flkochu/Arca9/datos/2026-11-09_flexion_fl/resumen.md

# Prueba 08 · Flexión y extensión — 20261109_182700

Rodilla FL (canal 2), de 5.0° a 125.8° de flexión (121°), cadera a +0°. 2 vueltas por velocidad. Fuente: 6.0 V.

| Velocidad pedida | Movimiento | Latencia (ms) | Atraso en la rampa (ms) | Vel. real (°/s) | Vel. pico (°/s) | Sobrepaso (°) | Asentamiento (ms) | Tiempo total (ms) | Error final (°) |
|---|---|---|---|---|---|---|---|---|---|
| 60 °/s | flexión | 76 | 105 | 61 | 94 | 0.2 | 117 | 2113 | 0.7 |
| 60 °/s | extensión | 84 | 86 | 60 | 118 | 0.3 | 91 | 2101 | 0.9 |
| 120 °/s | flexión | 67 | 101 | 120 | 176 | 0.2 | 146 | 1149 | 0.5 |
| 120 °/s | extensión | 76 | 97 | 120 | 212 | 0.3 | 165 | 1166 | 1.1 |
| 180 °/s | flexión | 53 | 102 | 180 | 229 | 0.2 | 177 | 840 | 0.6 |
| 180 °/s | extensión | 78 | 101 | 179 | 260 | 0.2 | 176 | 841 | 1.1 |
| 240 °/s | flexión | 54 | 104 | 237 | 273 | 0.2 | 184 | 682 | 0.8 |
| 240 °/s | extensión | 89 | 105 | 242 | 315 | 0.2 | 194 | 685 | 1.1 |
| máx. 376 °/s | flexión | 55 | 135 | 265 | 287 | 0.2 | 290 | 605 | 0.9 |
| máx. 376 °/s | extensión | 96 | 125 | 277 | 316 | 0.2 | 283 | 589 | 1.0 |

- **Latencia:** desde que el pedido se movió 2° hasta que el cable verde se movió 2°.
- **Tiempo total:** desde el primer pulso nuevo hasta que la rodilla quedó a ±1° de donde se quedó.
- **Atraso en la rampa:** en la segunda mitad de la rampa (como la prueba 04); a la velocidad máxima la rampa dura muy poco (0.3 s) y es menos confiable.
