flkochu/Arca9/datos/2026-11-03_marcha/resumen.md

# 05 · Marcha en el aire — resumen

| | |
|---|---|
| Fecha | 20261103_194555 |
| Pata | FL (canales [0, 1, 2]) |
| Paso | 6 cm de largo, 3 cm de alto, centro en x = 2 cm, z = 18.5 cm; 60 % de apoyo; 4 pasos por corrida |
| Adelanto | 100 ms |
| Fuente | 5.99 V |
| Simulado | no |

| Periodo (s) | Modo | Pie RMS (cm) | Pie máx (cm) | Largo hecho (cm) | Alto hecho (cm) | Cadera RMS (°) | Rodilla RMS (°) | Abducción RMS (°) | Atraso cadera (ms) | Atraso rodilla (ms) |
|---|---|---|---|---|---|---|---|---|---|---|
| 2 | sin compensar | 0.99 | 2.34 | 6.3 | 3.0 | 3.4 | 4.1 | 1.5 | 100 | 106 |
| 2 | con adelanto | 0.51 | 0.83 | 6.3 | 3.0 | 1.1 | 1.0 | 1.5 | 0 | 8 |
| 1.2 | sin compensar | 1.46 | 3.21 | 6.1 | 2.7 | 5.2 | 6.1 | 1.5 | 100 | 106 |
| 1.2 | con adelanto | 0.50 | 0.98 | 6.2 | 2.7 | 1.2 | 1.2 | 1.5 | 0 | 6 |
| 0.8 | sin compensar | 1.95 | 3.96 | 6.0 | 2.7 | 7.1 | 7.9 | 1.5 | 98 | 102 |
| 0.8 | con adelanto | 0.49 | 0.89 | 6.0 | 2.7 | 1.4 | 1.5 | 1.5 | 2 | 6 |

Lo pedido: 6 cm de largo y 3 cm de alto. El alto hecho incluye la diferencia de altura entre el apoyo y el punto más alto del vuelo.
