flkochu/Arca9/datos/2026-11-02_rampas/resumen.md

# 04 · Rampas — resumen

| | |
|---|---|
| Fecha | 20261102_212328 |
| Recorrido | 30° → 150° reales (819 → 2097 µs) |
| Vueltas | 3 idas y vueltas por servo y velocidad, 500 ms quieto en cada extremo |
| Fuente | 5.99 V |
| Simulado | no |
| Completa | sí |

## Promedio de los servos, por velocidad

Entre paréntesis, el servo con el valor más bajo y el más alto.

| Pedida (°/s) | Velocidad real (°/s) | Error en la rampa (°) | Atraso (ms) | Error máx (°) | Sobrepaso (°) | Asentamiento (ms) | Error final (°) |
|---|---|---|---|---|---|---|---|
| 60 | 60 (59–60) | 6.0 (5.8–6.2) | 100 (96–103) | 7.7 (7.1–8.4) | 0.76 (0.28–1.68) | 222 (91–464) | -0.83 (-1.36–-0.39) |
| 100 | 99 (99–100) | 10.2 (9.7–10.5) | 102 (97–105) | 12.3 (11.6–12.8) | 0.73 (0.22–1.33) | 234 (128–426) | -0.51 (-0.63–-0.26) |
| 120 | 119 (118–120) | 12.3 (11.8–12.7) | 103 (98–106) | 14.6 (13.8–14.9) | 0.49 (0.20–1.00) | 168 (132–253) | -0.35 (-0.62–-0.19) |
| 160 | 158 (156–160) | 16.4 (15.8–16.9) | 103 (99–106) | 19.2 (18.4–19.9) | 0.52 (0.19–1.03) | 191 (155–310) | -0.35 (-0.60–-0.17) |
| 180 | 179 (173–185) | 18.7 (17.8–19.3) | 104 (99–107) | 21.7 (20.9–22.3) | 0.73 (0.37–1.09) | 247 (170–358) | -0.24 (-0.49–0.01) |
| 200 | 199 (196–202) | 20.9 (20.1–21.7) | 104 (100–108) | 24.3 (23.3–24.9) | 0.83 (0.28–1.26) | 306 (173–450) | -0.21 (-0.37–0.15) |
| 220 | 219 (217–221) | 23.2 (22.4–23.9) | 105 (102–109) | 26.9 (25.7–27.5) | 1.11 (0.31–2.50) | 345 (166–485) | -0.27 (-0.50–-0.03) |
| 240 | 238 (236–241) | 25.6 (24.7–26.3) | 107 (103–110) | 29.7 (28.4–30.6) | 1.51 (0.44–2.86) | 378 (197–488) | -0.26 (-0.56–0.02) |

## Error en la rampa por servo (°)

| Servo | 60 °/s | 100 °/s | 120 °/s | 160 °/s | 180 °/s | 200 °/s | 220 °/s | 240 °/s |
|---|---|---|---|---|---|---|---|---|
| 0 · FL abducción | 5.8 | 9.7 | 11.8 | 15.9 | 18.1 | 20.3 | 22.4 | 24.8 |
| 1 · FL cadera | 5.8 | 9.7 | 11.9 | 15.8 | 17.8 | 20.1 | 22.5 | 24.7 |
| 2 · FL rodilla | 5.9 | 9.9 | 12.0 | 16.1 | 18.4 | 20.7 | 22.9 | 25.2 |
| 3 · FR abducción | 6.2 | 10.3 | 12.5 | 16.8 | 18.8 | 21.1 | 23.4 | 26.0 |
| 4 · FR cadera | 6.1 | 10.4 | 12.4 | 16.7 | 19.1 | 21.2 | 23.5 | 25.9 |
| 5 · FR rodilla | 6.2 | 10.5 | 12.6 | 16.9 | 19.3 | 21.7 | 23.9 | 26.3 |
| 6 · RL abducción | 5.9 | 10.1 | 12.1 | 16.2 | 18.5 | 20.5 | 22.8 | 25.2 |
| 7 · RL cadera | 6.0 | 10.3 | 12.6 | 16.6 | 19.0 | 21.1 | 23.3 | 25.9 |
| 8 · RL rodilla | 6.1 | 10.2 | 12.4 | 16.5 | 18.6 | 20.8 | 22.9 | 25.7 |
| 9 · RR abducción | 6.1 | 10.4 | 12.5 | 16.6 | 18.6 | 20.9 | 23.4 | 26.0 |
| 10 · RR cadera | 6.0 | 10.3 | 12.3 | 16.4 | 18.7 | 21.0 | 23.1 | 25.5 |
| 11 · RR rodilla | 6.2 | 10.5 | 12.7 | 16.8 | 18.9 | 21.1 | 23.6 | 26.0 |

## Atraso por servo (ms)

| Servo | 60 °/s | 100 °/s | 120 °/s | 160 °/s | 180 °/s | 200 °/s | 220 °/s | 240 °/s |
|---|---|---|---|---|---|---|---|---|
| 0 · FL abducción | 97 | 97 | 98 | 99 | 100 | 101 | 102 | 104 |
| 1 · FL cadera | 96 | 97 | 99 | 99 | 99 | 100 | 102 | 103 |
| 2 · FL rodilla | 98 | 99 | 100 | 100 | 102 | 104 | 104 | 105 |
| 3 · FR abducción | 103 | 103 | 104 | 105 | 104 | 105 | 106 | 108 |
| 4 · FR cadera | 102 | 104 | 104 | 104 | 106 | 106 | 107 | 108 |
| 5 · FR rodilla | 103 | 105 | 105 | 106 | 107 | 108 | 109 | 110 |
| 6 · RL abducción | 98 | 101 | 101 | 101 | 103 | 102 | 104 | 105 |
| 7 · RL cadera | 100 | 103 | 105 | 104 | 106 | 106 | 106 | 108 |
| 8 · RL rodilla | 101 | 102 | 103 | 103 | 103 | 104 | 104 | 107 |
| 9 · RR abducción | 101 | 104 | 104 | 104 | 104 | 104 | 106 | 108 |
| 10 · RR cadera | 99 | 103 | 103 | 102 | 104 | 105 | 105 | 106 |
| 11 · RR rodilla | 103 | 105 | 106 | 105 | 105 | 106 | 107 | 108 |
