flkochu/Arca9/datos/README.md

# Datos

Una carpeta por corrida real, con el nombre `AAAA-MM-DD_prueba`. Se copian tal como las deja el
script, sin editarlas. La nota de cada una está en `docs/bitacora/`.

| Carpeta | Prueba |
|---|---|
| `2026-10-29_eficiencia_12_servos/` | [01 · Eficiencia de los 12 servos](../docs/bitacora/01_eficiencia_servos.md) |
| `2026-11-03_marcha/` | [05 · Marcha en el aire con la pata FL](../docs/bitacora/05_marcha_aire.md) |
| `2026-11-03_pata_fl/` | Medidas de la pata FL armada: largos, límites, poses y sentidos (`pata_fl.json`, lo lee `pc/pata.py`) |
| `2026-11-02_rampas/` | [04 · Rampas: velocidad contra error](../docs/bitacora/04_rampas.md). Analizada con la versión corregida de `rampas.py` (segunda mitad de cada rampa) |
| `2026-11-02_angulo_real/` | [02 · Ángulo real, con transportador](../docs/bitacora/02_angulo_real.md). Medida a mano; `escala.json` lo lee `pc/escala.py` |
