flkochu/Arca9/datos/2026-10-29_eficiencia_12_servos/canal0/tabla.md

# Canal 0 · FL abducción

- Rango útil: 0° a 168° (500–2367 µs), 191–1867 mV en el pin
- Recta: ángulo = -0.10018·mV +186.87  (9.98 mV por grado), R² = 0.99996
- Error con la recta: RMS 0.32°, máx 0.94°, 100 % de los puntos dentro de ±1°
- Error con la tabla (de 2 en 2°, probada con otras pasadas): RMS 0.22°, máx 0.61°, 100 % dentro de ±1°
- Histéresis: máx 0.87°, media 0.24°
- Ruido con el servo quieto: σ 2.98 mV = 0.299°
- Por pasada (recta de cada una contra la de todos los datos):
  - de 30 en 30°: 12 puntos, R² 0.99997, se separa hasta 0.06°, error RMS 0.27°
  - de 20 en 20°: 18 puntos, R² 0.99997, se separa hasta 0.07°, error RMS 0.28°
  - de 10 en 10°: 34 puntos, R² 0.99997, se separa hasta 0.03°, error RMS 0.27°
  - de 5 en 5°: 68 puntos, R² 0.99996, se separa hasta 0.03°, error RMS 0.31°
  - de 2 en 2°: 170 puntos, R² 0.99995, se separa hasta 0.02°, error RMS 0.34°

## Pasada 1: de 30 en 30°

| Ángulo (°) | Pulso (µs) | mV ↑ | mV ↓ | Medido (°) | Error (°) | Histéresis (°) | |
|---|---|---|---|---|---|---|---|
| 0 | 500 | 1864.2 | 1867.1 | -0.03 | -0.03 | 0.29 |  |
| 30 | 833 | 1569.9 | 1568.0 | 29.70 | -0.30 | 0.19 |  |
| 60 | 1167 | 1267.8 | 1261.7 | 60.17 | +0.17 | 0.61 |  |
| 90 | 1500 | 965.2 | 964.8 | 90.20 | +0.20 | 0.04 |  |
| 120 | 1833 | 671.7 | 670.4 | 119.64 | -0.36 | 0.13 |  |
| 150 | 2167 | 368.4 | 367.0 | 150.03 | +0.03 | 0.14 |  |
| 175 | 2444 | 193.2 | 193.0 | 167.52 | -7.48 | 0.02 | fuera |

## Pasada 2: de 20 en 20°

| Ángulo (°) | Pulso (µs) | mV ↑ | mV ↓ | Medido (°) | Error (°) | Histéresis (°) | |
|---|---|---|---|---|---|---|---|
| 0 | 500 | 1867.0 | 1865.4 | -0.08 | -0.08 | 0.16 |  |
| 20 | 722 | 1668.3 | 1666.7 | 19.82 | -0.18 | 0.16 |  |
| 40 | 944 | 1468.1 | 1466.1 | 39.90 | -0.10 | 0.20 |  |
| 60 | 1167 | 1268.4 | 1266.6 | 59.89 | -0.11 | 0.18 |  |
| 80 | 1389 | 1066.0 | 1066.0 | 80.08 | +0.08 | 0.00 |  |
| 100 | 1611 | 862.2 | 862.5 | 100.48 | +0.48 | 0.03 |  |
| 120 | 1833 | 667.7 | 669.9 | 119.87 | -0.13 | 0.22 |  |
| 140 | 2056 | 467.4 | 465.1 | 140.16 | +0.16 | 0.23 |  |
| 160 | 2278 | 274.2 | 273.1 | 159.45 | -0.55 | 0.11 |  |
| 175 | 2444 | 190.8 | 191.0 | 167.74 | -7.26 | 0.02 | fuera |

## Pasada 3: de 10 en 10°

| Ángulo (°) | Pulso (µs) | mV ↑ | mV ↓ | Medido (°) | Error (°) | Histéresis (°) | |
|---|---|---|---|---|---|---|---|
| 0 | 500 | 1864.9 | 1863.6 | 0.11 | +0.11 | 0.13 |  |
| 10 | 611 | 1765.5 | 1767.8 | 9.89 | -0.11 | 0.23 |  |
| 20 | 722 | 1666.6 | 1666.5 | 19.92 | -0.08 | 0.01 |  |
| 30 | 833 | 1571.5 | 1567.5 | 29.64 | -0.36 | 0.40 |  |
| 40 | 944 | 1468.2 | 1467.3 | 39.83 | -0.17 | 0.09 |  |
| 50 | 1056 | 1367.0 | 1366.4 | 49.96 | -0.04 | 0.06 |  |
| 60 | 1167 | 1267.5 | 1264.6 | 60.04 | +0.04 | 0.29 |  |
| 70 | 1278 | 1167.0 | 1161.6 | 70.23 | +0.23 | 0.54 |  |
| 80 | 1389 | 1064.4 | 1065.5 | 80.18 | +0.18 | 0.11 |  |
| 90 | 1500 | 966.9 | 965.3 | 90.09 | +0.09 | 0.16 |  |
| 100 | 1611 | 864.9 | 861.2 | 100.41 | +0.41 | 0.37 |  |
| 110 | 1722 | 762.8 | 764.4 | 110.37 | +0.37 | 0.16 |  |
| 120 | 1833 | 670.2 | 670.2 | 119.73 | -0.27 | 0.00 |  |
| 130 | 1944 | 569.3 | 568.7 | 129.87 | -0.13 | 0.06 |  |
| 140 | 2056 | 468.9 | 466.9 | 140.00 | -0.00 | 0.20 |  |
| 150 | 2167 | 370.1 | 365.2 | 150.04 | +0.04 | 0.49 |  |
| 160 | 2278 | 273.3 | 273.3 | 159.49 | -0.51 | 0.00 |  |
| 170 | 2389 | 189.3 | 189.4 | 167.90 | -2.10 | 0.01 | fuera |
| 175 | 2444 | 189.6 | 189.6 | 167.87 | -7.13 | 0.00 | fuera |

## Pasada 4: de 5 en 5°

| Ángulo (°) | Pulso (µs) | mV ↑ | mV ↓ | Medido (°) | Error (°) | Histéresis (°) | |
|---|---|---|---|---|---|---|---|
| 0 | 500 | 1864.2 | 1864.2 | 0.12 | +0.12 | 0.00 |  |
| 5 | 556 | 1819.9 | 1816.4 | 4.73 | -0.27 | 0.35 |  |
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
| 72 | 1300 | 1148.9 | 1147.0 | 71.87 | -0.13 | 0.19 |  |
| 74 | 1322 | 1127.4 | 1126.8 | 73.96 | -0.04 | 0.06 |  |
| 76 | 1344 | 1108.7 | 1106.4 | 75.92 | -0.08 | 0.23 |  |
| 78 | 1367 | 1085.5 | 1083.6 | 78.22 | +0.22 | 0.19 |  |
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
| 170 | 2389 | 190.9 | 191.3 | 167.72 | -2.28 | 0.04 | fuera |
| 172 | 2411 | 192.0 | 191.1 | 167.68 | -4.32 | 0.09 | fuera |
| 174 | 2433 | 190.9 | 190.8 | 167.75 | -6.25 | 0.01 | fuera |
| 175 | 2444 | 191.1 | 191.2 | 167.72 | -7.28 | 0.01 | fuera |

## Avisos

- Fuera del rango útil (llegó a su tope o no siguió el comando): 170, 172, 174, 175°.
