flkochu/Arca9/datos/2026-10-29_eficiencia_12_servos/canal1/tabla.md

# Canal 1 · FL cadera

- Rango útil: 0° a 168° (500–2367 µs), 192–1858 mV en el pin
- Recta: ángulo = -0.10071·mV +186.94  (9.93 mV por grado), R² = 0.99996
- Error con la recta: RMS 0.32°, máx 0.98°, 100 % de los puntos dentro de ±1°
- Error con la tabla (de 2 en 2°, probada con otras pasadas): RMS 0.25°, máx 0.87°, 100 % dentro de ±1°
- Histéresis: máx 1.01°, media 0.20°
- Ruido con el servo quieto: σ 3.28 mV = 0.330°
- Por pasada (recta de cada una contra la de todos los datos):
  - de 30 en 30°: 12 puntos, R² 0.99998, se separa hasta 0.13°, error RMS 0.22°
  - de 20 en 20°: 18 puntos, R² 0.99998, se separa hasta 0.09°, error RMS 0.27°
  - de 10 en 10°: 34 puntos, R² 0.99997, se separa hasta 0.11°, error RMS 0.29°
  - de 5 en 5°: 68 puntos, R² 0.99995, se separa hasta 0.01°, error RMS 0.33°
  - de 2 en 2°: 170 puntos, R² 0.99995, se separa hasta 0.04°, error RMS 0.34°

## Pasada 1: de 30 en 30°

| Ángulo (°) | Pulso (µs) | mV ↑ | mV ↓ | Medido (°) | Error (°) | Histéresis (°) | |
|---|---|---|---|---|---|---|---|
| 0 | 500 | 1857.5 | 1857.0 | -0.11 | -0.11 | 0.05 |  |
| 30 | 833 | 1558.3 | 1557.6 | 30.04 | +0.04 | 0.07 |  |
| 60 | 1167 | 1259.6 | 1262.1 | 59.96 | -0.04 | 0.25 |  |
| 90 | 1500 | 959.7 | 958.1 | 90.37 | +0.37 | 0.16 |  |
| 120 | 1833 | 665.8 | 666.4 | 119.86 | -0.14 | 0.06 |  |
| 150 | 2167 | 368.5 | 371.0 | 149.70 | -0.30 | 0.25 |  |
| 175 | 2444 | 190.7 | 191.5 | 167.69 | -7.31 | 0.08 | fuera |

## Pasada 2: de 20 en 20°

| Ángulo (°) | Pulso (µs) | mV ↑ | mV ↓ | Medido (°) | Error (°) | Histéresis (°) | |
|---|---|---|---|---|---|---|---|
| 0 | 500 | 1857.9 | 1856.0 | -0.08 | -0.08 | 0.19 |  |
| 20 | 722 | 1661.7 | 1661.4 | 19.60 | -0.40 | 0.03 |  |
| 40 | 944 | 1460.5 | 1458.8 | 39.94 | -0.06 | 0.17 |  |
| 60 | 1167 | 1260.8 | 1259.9 | 60.01 | +0.01 | 0.09 |  |
| 80 | 1389 | 1059.8 | 1061.3 | 80.13 | +0.13 | 0.15 |  |
| 100 | 1611 | 862.6 | 858.9 | 100.25 | +0.25 | 0.37 |  |
| 120 | 1833 | 668.0 | 664.0 | 119.87 | -0.13 | 0.40 |  |
| 140 | 2056 | 465.0 | 465.3 | 140.09 | +0.09 | 0.03 |  |
| 160 | 2278 | 271.7 | 273.6 | 159.48 | -0.52 | 0.19 |  |
| 175 | 2444 | 191.5 | 191.7 | 167.64 | -7.36 | 0.02 | fuera |

## Pasada 3: de 10 en 10°

| Ángulo (°) | Pulso (µs) | mV ↑ | mV ↓ | Medido (°) | Error (°) | Histéresis (°) | |
|---|---|---|---|---|---|---|---|
| 0 | 500 | 1856.2 | 1856.6 | -0.02 | -0.02 | 0.04 |  |
| 10 | 611 | 1757.7 | 1756.1 | 10.00 | -0.00 | 0.16 |  |
| 20 | 722 | 1659.6 | 1661.5 | 19.70 | -0.30 | 0.19 |  |
| 30 | 833 | 1557.5 | 1558.4 | 30.04 | +0.04 | 0.09 |  |
| 40 | 944 | 1461.5 | 1460.3 | 39.81 | -0.19 | 0.12 |  |
| 50 | 1056 | 1364.6 | 1361.4 | 49.67 | -0.33 | 0.32 |  |
| 60 | 1167 | 1261.2 | 1262.1 | 59.88 | -0.12 | 0.09 |  |
| 70 | 1278 | 1160.0 | 1159.9 | 70.12 | +0.12 | 0.01 |  |
| 80 | 1389 | 1060.2 | 1058.8 | 80.24 | +0.24 | 0.14 |  |
| 90 | 1500 | 959.3 | 961.3 | 90.23 | +0.23 | 0.20 |  |
| 100 | 1611 | 859.3 | 858.1 | 100.46 | +0.46 | 0.12 |  |
| 110 | 1722 | 760.3 | 759.4 | 110.41 | +0.41 | 0.09 |  |
| 120 | 1833 | 666.1 | 666.5 | 119.84 | -0.16 | 0.04 |  |
| 130 | 1944 | 567.3 | 566.4 | 129.85 | -0.15 | 0.09 |  |
| 140 | 2056 | 467.3 | 466.0 | 139.94 | -0.06 | 0.13 |  |
| 150 | 2167 | 370.8 | 368.8 | 149.70 | -0.30 | 0.20 |  |
| 160 | 2278 | 274.1 | 273.6 | 159.36 | -0.64 | 0.05 |  |
| 170 | 2389 | 190.4 | 190.7 | 167.75 | -2.25 | 0.03 | fuera |
| 175 | 2444 | 190.8 | 190.7 | 167.73 | -7.27 | 0.01 | fuera |

## Pasada 4: de 5 en 5°

| Ángulo (°) | Pulso (µs) | mV ↑ | mV ↓ | Medido (°) | Error (°) | Histéresis (°) | |
|---|---|---|---|---|---|---|---|
| 0 | 500 | 1857.5 | 1855.6 | -0.04 | -0.04 | 0.19 |  |
| 5 | 556 | 1810.6 | 1810.4 | 4.60 | -0.40 | 0.02 |  |
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
| 72 | 1300 | 1141.5 | 1140.3 | 72.04 | +0.04 | 0.12 |  |
| 74 | 1322 | 1118.0 | 1118.6 | 74.31 | +0.31 | 0.06 |  |
| 76 | 1344 | 1106.3 | 1099.7 | 75.85 | -0.15 | 0.66 |  |
| 78 | 1367 | 1083.2 | 1080.6 | 77.98 | -0.02 | 0.26 |  |
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
| 170 | 2389 | 192.8 | 192.8 | 167.52 | -2.48 | 0.00 | fuera |
| 172 | 2411 | 192.6 | 192.7 | 167.54 | -4.46 | 0.01 | fuera |
| 174 | 2433 | 192.9 | 192.7 | 167.52 | -6.48 | 0.02 | fuera |
| 175 | 2444 | 192.6 | 192.2 | 167.56 | -7.44 | 0.04 | fuera |

## Avisos

- Fuera del rango útil (llegó a su tope o no siguió el comando): 170, 172, 174, 175°.
