flkochu/Arca9/datos/2026-10-29_eficiencia_12_servos/canal10/tabla.md

# Canal 10 · RR cadera

- Rango útil: 0° a 170° (500–2389 µs), 180–1858 mV en el pin
- Recta: ángulo = -0.10051·mV +186.66  (9.95 mV por grado), R² = 0.99994
- Error con la recta: RMS 0.40°, máx 1.83°, 98 % de los puntos dentro de ±1°
- Error con la tabla (de 2 en 2°, probada con otras pasadas): RMS 0.24°, máx 1.02°, 99 % dentro de ±1°
- Histéresis: máx 0.80°, media 0.22°
- Ruido con el servo quieto: σ 5.53 mV = 0.555°
- Por pasada (recta de cada una contra la de todos los datos):
  - de 30 en 30°: 12 puntos, R² 0.99999, se separa hasta 0.16°, error RMS 0.16°
  - de 20 en 20°: 18 puntos, R² 0.99997, se separa hasta 0.19°, error RMS 0.31°
  - de 10 en 10°: 36 puntos, R² 0.99992, se separa hasta 0.23°, error RMS 0.49°
  - de 5 en 5°: 70 puntos, R² 0.99992, se separa hasta 0.06°, error RMS 0.44°
  - de 2 en 2°: 172 puntos, R² 0.99994, se separa hasta 0.10°, error RMS 0.39°

## Pasada 1: de 30 en 30°

| Ángulo (°) | Pulso (µs) | mV ↑ | mV ↓ | Medido (°) | Error (°) | Histéresis (°) | |
|---|---|---|---|---|---|---|---|
| 0 | 500 | 1856.5 | 1858.1 | -0.02 | -0.02 | 0.16 |  |
| 30 | 833 | 1558.4 | 1559.2 | 29.98 | -0.02 | 0.08 |  |
| 60 | 1167 | 1262.7 | 1258.3 | 59.97 | -0.03 | 0.44 |  |
| 90 | 1500 | 963.8 | 964.6 | 89.75 | -0.25 | 0.08 |  |
| 120 | 1833 | 664.0 | 665.4 | 119.85 | -0.15 | 0.14 |  |
| 150 | 2167 | 366.1 | 364.4 | 149.95 | -0.05 | 0.17 |  |
| 175 | 2444 | 183.8 | 182.9 | 168.23 | -6.77 | 0.09 | fuera |

## Pasada 2: de 20 en 20°

| Ángulo (°) | Pulso (µs) | mV ↑ | mV ↓ | Medido (°) | Error (°) | Histéresis (°) | |
|---|---|---|---|---|---|---|---|
| 0 | 500 | 1857.5 | 1857.5 | -0.04 | -0.04 | 0.00 |  |
| 20 | 722 | 1659.9 | 1658.5 | 19.89 | -0.11 | 0.14 |  |
| 40 | 944 | 1459.7 | 1460.0 | 39.93 | -0.07 | 0.03 |  |
| 60 | 1167 | 1263.7 | 1261.9 | 59.74 | -0.26 | 0.18 |  |
| 80 | 1389 | 1058.0 | 1057.8 | 80.33 | +0.33 | 0.02 |  |
| 100 | 1611 | 861.2 | 858.7 | 100.23 | +0.23 | 0.25 |  |
| 120 | 1833 | 663.6 | 666.0 | 119.84 | -0.16 | 0.24 |  |
| 140 | 2056 | 463.4 | 462.1 | 140.15 | +0.15 | 0.13 |  |
| 160 | 2278 | 273.1 | 271.7 | 159.28 | -0.72 | 0.14 |  |
| 175 | 2444 | 185.7 | 186.2 | 167.97 | -7.03 | 0.05 | fuera |

## Pasada 3: de 10 en 10°

| Ángulo (°) | Pulso (µs) | mV ↑ | mV ↓ | Medido (°) | Error (°) | Histéresis (°) | |
|---|---|---|---|---|---|---|---|
| 0 | 500 | 1857.8 | 1858.2 | -0.09 | -0.09 | 0.04 |  |
| 10 | 611 | 1761.8 | 1758.0 | 9.77 | -0.23 | 0.38 |  |
| 20 | 722 | 1661.7 | 1659.7 | 19.74 | -0.26 | 0.20 |  |
| 30 | 833 | 1560.0 | 1559.6 | 29.88 | -0.12 | 0.04 |  |
| 40 | 944 | 1458.7 | 1460.2 | 39.97 | -0.03 | 0.15 |  |
| 50 | 1056 | 1358.5 | 1358.9 | 50.10 | +0.10 | 0.04 |  |
| 60 | 1167 | 1262.2 | 1259.0 | 59.96 | -0.04 | 0.32 |  |
| 70 | 1278 | 1161.0 | 1161.2 | 69.96 | -0.04 | 0.02 |  |
| 80 | 1389 | 1059.9 | 1058.1 | 80.22 | +0.22 | 0.18 |  |
| 90 | 1500 | 956.9 | 959.8 | 90.34 | +0.34 | 0.29 |  |
| 100 | 1611 | 859.6 | 858.9 | 100.30 | +0.30 | 0.07 |  |
| 110 | 1722 | 758.7 | 758.1 | 110.43 | +0.43 | 0.06 |  |
| 120 | 1833 | 662.8 | 661.7 | 120.10 | +0.10 | 0.11 |  |
| 130 | 1944 | 564.9 | 562.4 | 130.01 | +0.01 | 0.25 |  |
| 140 | 2056 | 463.4 | 459.8 | 140.26 | +0.26 | 0.36 |  |
| 150 | 2167 | 364.7 | 365.4 | 149.97 | -0.03 | 0.07 |  |
| 160 | 2278 | 271.4 | 265.4 | 159.68 | -0.32 | 0.60 |  |
| 170 | 2389 | 183.5 | 184.0 | 168.19 | -1.81 | 0.05 |  |
| 175 | 2444 | 184.3 | 183.9 | 168.16 | -6.84 | 0.04 | fuera |

## Pasada 4: de 5 en 5°

| Ángulo (°) | Pulso (µs) | mV ↑ | mV ↓ | Medido (°) | Error (°) | Histéresis (°) | |
|---|---|---|---|---|---|---|---|
| 0 | 500 | 1857.5 | 1855.9 | 0.04 | +0.04 | 0.16 |  |
| 5 | 556 | 1810.8 | 1809.7 | 4.71 | -0.29 | 0.11 |  |
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
| 72 | 1300 | 1141.9 | 1142.4 | 71.86 | -0.14 | 0.05 |  |
| 74 | 1322 | 1121.5 | 1117.8 | 74.12 | +0.12 | 0.37 |  |
| 76 | 1344 | 1103.7 | 1098.8 | 75.97 | -0.03 | 0.49 |  |
| 78 | 1367 | 1080.0 | 1078.3 | 78.19 | +0.19 | 0.17 |  |
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
| 172 | 2411 | 181.2 | 181.0 | 168.46 | -3.54 | 0.02 | fuera |
| 174 | 2433 | 181.1 | 180.9 | 168.47 | -5.53 | 0.02 | fuera |
| 175 | 2444 | 181.1 | 180.4 | 168.49 | -6.51 | 0.07 | fuera |

## Avisos

- Fuera del rango útil (llegó a su tope o no siguió el comando): 172, 174, 175°.
