flkochu/Arca9/datos/2026-10-29_eficiencia_12_servos/canal11/tabla.md

# Canal 11 · RR rodilla

- Rango útil: 0° a 168° (500–2367 µs), 185–1878 mV en el pin
- Recta: ángulo = -0.09912·mV +186.08  (10.09 mV por grado), R² = 0.99996
- Error con la recta: RMS 0.32°, máx 0.89°, 100 % de los puntos dentro de ±1°
- Error con la tabla (de 2 en 2°, probada con otras pasadas): RMS 0.22°, máx 0.56°, 100 % dentro de ±1°
- Histéresis: máx 0.73°, media 0.22°
- Ruido con el servo quieto: σ 4.23 mV = 0.419°
- Por pasada (recta de cada una contra la de todos los datos):
  - de 30 en 30°: 12 puntos, R² 0.99999, se separa hasta 0.15°, error RMS 0.20°
  - de 20 en 20°: 18 puntos, R² 0.99997, se separa hasta 0.18°, error RMS 0.29°
  - de 10 en 10°: 34 puntos, R² 0.99996, se separa hasta 0.10°, error RMS 0.33°
  - de 5 en 5°: 68 puntos, R² 0.99995, se separa hasta 0.04°, error RMS 0.33°
  - de 2 en 2°: 170 puntos, R² 0.99996, se separa hasta 0.06°, error RMS 0.32°

## Pasada 1: de 30 en 30°

| Ángulo (°) | Pulso (µs) | mV ↑ | mV ↓ | Medido (°) | Error (°) | Histéresis (°) | |
|---|---|---|---|---|---|---|---|
| 0 | 500 | 1873.8 | 1875.0 | 0.30 | +0.30 | 0.12 |  |
| 30 | 833 | 1577.5 | 1574.9 | 29.86 | -0.14 | 0.26 |  |
| 60 | 1167 | 1270.2 | 1268.9 | 60.25 | +0.25 | 0.13 |  |
| 90 | 1500 | 971.1 | 968.5 | 89.96 | -0.04 | 0.26 |  |
| 120 | 1833 | 668.0 | 667.6 | 119.89 | -0.11 | 0.04 |  |
| 150 | 2167 | 364.4 | 362.3 | 150.07 | +0.07 | 0.21 |  |
| 175 | 2444 | 183.4 | 184.3 | 167.86 | -7.14 | 0.09 | fuera |

## Pasada 2: de 20 en 20°

| Ángulo (°) | Pulso (µs) | mV ↑ | mV ↓ | Medido (°) | Error (°) | Histéresis (°) | |
|---|---|---|---|---|---|---|---|
| 0 | 500 | 1874.5 | 1877.1 | 0.16 | +0.16 | 0.26 |  |
| 20 | 722 | 1680.2 | 1674.4 | 19.84 | -0.16 | 0.57 |  |
| 40 | 944 | 1474.6 | 1472.2 | 40.05 | +0.05 | 0.24 |  |
| 60 | 1167 | 1270.2 | 1269.0 | 60.25 | +0.25 | 0.12 |  |
| 80 | 1389 | 1069.4 | 1068.0 | 80.16 | +0.16 | 0.14 |  |
| 100 | 1611 | 864.9 | 864.0 | 100.40 | +0.40 | 0.09 |  |
| 120 | 1833 | 669.9 | 668.5 | 119.76 | -0.24 | 0.14 |  |
| 140 | 2056 | 467.7 | 464.7 | 139.88 | -0.12 | 0.30 |  |
| 160 | 2278 | 269.6 | 264.9 | 159.60 | -0.40 | 0.47 |  |
| 175 | 2444 | 182.5 | 182.5 | 168.00 | -7.00 | 0.00 | fuera |

## Pasada 3: de 10 en 10°

| Ángulo (°) | Pulso (µs) | mV ↑ | mV ↓ | Medido (°) | Error (°) | Histéresis (°) | |
|---|---|---|---|---|---|---|---|
| 0 | 500 | 1877.5 | 1875.3 | 0.10 | +0.10 | 0.22 |  |
| 10 | 611 | 1780.3 | 1782.9 | 9.50 | -0.50 | 0.26 |  |
| 20 | 722 | 1678.2 | 1676.1 | 19.85 | -0.15 | 0.21 |  |
| 30 | 833 | 1580.6 | 1575.3 | 29.68 | -0.32 | 0.53 |  |
| 40 | 944 | 1475.8 | 1472.5 | 39.97 | -0.03 | 0.33 |  |
| 50 | 1056 | 1375.5 | 1374.6 | 49.79 | -0.21 | 0.09 |  |
| 60 | 1167 | 1270.8 | 1271.8 | 60.08 | +0.08 | 0.10 |  |
| 70 | 1278 | 1172.8 | 1171.2 | 69.92 | -0.08 | 0.16 |  |
| 80 | 1389 | 1070.8 | 1070.1 | 79.98 | -0.02 | 0.07 |  |
| 90 | 1500 | 974.0 | 971.8 | 89.65 | -0.35 | 0.22 |  |
| 100 | 1611 | 863.1 | 863.9 | 100.50 | +0.50 | 0.08 |  |
| 110 | 1722 | 766.7 | 761.7 | 110.34 | +0.34 | 0.50 |  |
| 120 | 1833 | 668.7 | 667.8 | 119.85 | -0.15 | 0.09 |  |
| 130 | 1944 | 566.5 | 568.0 | 129.86 | -0.14 | 0.15 |  |
| 140 | 2056 | 463.1 | 462.1 | 140.23 | +0.23 | 0.10 |  |
| 150 | 2167 | 369.4 | 366.6 | 149.61 | -0.39 | 0.28 |  |
| 160 | 2278 | 271.4 | 267.0 | 159.40 | -0.60 | 0.44 |  |
| 170 | 2389 | 183.1 | 182.7 | 167.96 | -2.04 | 0.04 | fuera |
| 175 | 2444 | 183.4 | 182.8 | 167.94 | -7.06 | 0.06 | fuera |

## Pasada 4: de 5 en 5°

| Ángulo (°) | Pulso (µs) | mV ↑ | mV ↓ | Medido (°) | Error (°) | Histéresis (°) | |
|---|---|---|---|---|---|---|---|
| 0 | 500 | 1875.7 | 1875.4 | 0.19 | +0.19 | 0.03 |  |
| 5 | 556 | 1829.0 | 1826.6 | 4.92 | -0.08 | 0.24 |  |
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
| 72 | 1300 | 1152.9 | 1150.9 | 71.91 | -0.09 | 0.20 |  |
| 74 | 1322 | 1132.9 | 1130.3 | 73.92 | -0.08 | 0.26 |  |
| 76 | 1344 | 1113.1 | 1111.4 | 75.84 | -0.16 | 0.17 |  |
| 78 | 1367 | 1091.6 | 1088.2 | 78.06 | +0.06 | 0.34 |  |
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
| 170 | 2389 | 185.3 | 185.2 | 167.72 | -2.28 | 0.01 | fuera |
| 172 | 2411 | 185.0 | 184.8 | 167.76 | -4.24 | 0.02 | fuera |
| 174 | 2433 | 184.9 | 185.2 | 167.74 | -6.26 | 0.03 | fuera |
| 175 | 2444 | 184.9 | 184.7 | 167.77 | -7.23 | 0.02 | fuera |

## Avisos

- Fuera del rango útil (llegó a su tope o no siguió el comando): 170, 172, 174, 175°.
