flkochu/Arca9/datos/2026-10-29_eficiencia_12_servos/canal2/tabla.md

# Canal 2 · FL rodilla

- Rango útil: 0° a 168° (500–2367 µs), 193–1874 mV en el pin
- Recta: ángulo = -0.09948·mV +186.32  (10.05 mV por grado), R² = 0.99995
- Error con la recta: RMS 0.33°, máx 1.06°, 100 % de los puntos dentro de ±1°
- Error con la tabla (de 2 en 2°, probada con otras pasadas): RMS 0.21°, máx 0.61°, 100 % dentro de ±1°
- Histéresis: máx 0.81°, media 0.21°
- Ruido con el servo quieto: σ 3.38 mV = 0.336°
- Por pasada (recta de cada una contra la de todos los datos):
  - de 30 en 30°: 12 puntos, R² 0.99999, se separa hasta 0.13°, error RMS 0.16°
  - de 20 en 20°: 18 puntos, R² 0.99996, se separa hasta 0.09°, error RMS 0.32°
  - de 10 en 10°: 34 puntos, R² 0.99997, se separa hasta 0.13°, error RMS 0.29°
  - de 5 en 5°: 68 puntos, R² 0.99996, se separa hasta 0.08°, error RMS 0.31°
  - de 2 en 2°: 170 puntos, R² 0.99995, se separa hasta 0.04°, error RMS 0.36°

## Pasada 1: de 30 en 30°

| Ángulo (°) | Pulso (µs) | mV ↑ | mV ↓ | Medido (°) | Error (°) | Histéresis (°) | |
|---|---|---|---|---|---|---|---|
| 0 | 500 | 1872.4 | 1870.0 | 0.18 | +0.18 | 0.24 |  |
| 30 | 833 | 1572.3 | 1573.3 | 29.86 | -0.14 | 0.10 |  |
| 60 | 1167 | 1270.1 | 1268.1 | 60.07 | +0.07 | 0.20 |  |
| 90 | 1500 | 967.4 | 966.6 | 90.12 | +0.12 | 0.08 |  |
| 120 | 1833 | 669.5 | 667.7 | 119.81 | -0.19 | 0.18 |  |
| 150 | 2167 | 366.1 | 365.7 | 149.92 | -0.08 | 0.04 |  |
| 175 | 2444 | 192.5 | 193.2 | 167.13 | -7.87 | 0.07 | fuera |

## Pasada 2: de 20 en 20°

| Ángulo (°) | Pulso (µs) | mV ↑ | mV ↓ | Medido (°) | Error (°) | Histéresis (°) | |
|---|---|---|---|---|---|---|---|
| 0 | 500 | 1870.0 | 1874.0 | 0.10 | +0.10 | 0.40 |  |
| 20 | 722 | 1676.7 | 1674.5 | 19.63 | -0.37 | 0.22 |  |
| 40 | 944 | 1472.4 | 1470.3 | 39.95 | -0.05 | 0.21 |  |
| 60 | 1167 | 1269.4 | 1269.0 | 60.06 | +0.06 | 0.04 |  |
| 80 | 1389 | 1064.8 | 1065.0 | 80.38 | +0.38 | 0.02 |  |
| 100 | 1611 | 863.3 | 863.8 | 100.41 | +0.41 | 0.05 |  |
| 120 | 1833 | 670.1 | 666.1 | 119.86 | -0.14 | 0.40 |  |
| 140 | 2056 | 465.9 | 464.0 | 140.06 | +0.06 | 0.19 |  |
| 160 | 2278 | 268.5 | 271.9 | 159.44 | -0.56 | 0.34 |  |
| 175 | 2444 | 193.1 | 193.2 | 167.10 | -7.90 | 0.01 | fuera |

## Pasada 3: de 10 en 10°

| Ángulo (°) | Pulso (µs) | mV ↑ | mV ↓ | Medido (°) | Error (°) | Histéresis (°) | |
|---|---|---|---|---|---|---|---|
| 0 | 500 | 1873.5 | 1874.0 | -0.08 | -0.08 | 0.05 |  |
| 10 | 611 | 1777.7 | 1776.4 | 9.54 | -0.46 | 0.13 |  |
| 20 | 722 | 1675.0 | 1675.3 | 19.68 | -0.32 | 0.03 |  |
| 30 | 833 | 1576.6 | 1573.5 | 29.64 | -0.36 | 0.31 |  |
| 40 | 944 | 1471.0 | 1472.0 | 39.94 | -0.06 | 0.10 |  |
| 50 | 1056 | 1373.7 | 1369.2 | 49.89 | -0.11 | 0.45 |  |
| 60 | 1167 | 1269.2 | 1268.1 | 60.11 | +0.11 | 0.11 |  |
| 70 | 1278 | 1166.7 | 1165.6 | 70.31 | +0.31 | 0.11 |  |
| 80 | 1389 | 1066.9 | 1063.6 | 80.35 | +0.35 | 0.33 |  |
| 90 | 1500 | 967.7 | 964.7 | 90.20 | +0.20 | 0.30 |  |
| 100 | 1611 | 862.8 | 865.1 | 100.37 | +0.37 | 0.23 |  |
| 110 | 1722 | 763.1 | 762.5 | 110.44 | +0.44 | 0.06 |  |
| 120 | 1833 | 666.8 | 669.7 | 119.84 | -0.16 | 0.29 |  |
| 130 | 1944 | 568.3 | 568.3 | 129.78 | -0.22 | 0.00 |  |
| 140 | 2056 | 464.4 | 464.3 | 140.12 | +0.12 | 0.01 |  |
| 150 | 2167 | 367.6 | 365.4 | 149.86 | -0.14 | 0.22 |  |
| 160 | 2278 | 267.7 | 267.5 | 159.70 | -0.30 | 0.02 |  |
| 170 | 2389 | 192.4 | 193.9 | 167.10 | -2.90 | 0.15 | fuera |
| 175 | 2444 | 192.8 | 192.5 | 167.15 | -7.85 | 0.03 | fuera |

## Pasada 4: de 5 en 5°

| Ángulo (°) | Pulso (µs) | mV ↑ | mV ↓ | Medido (°) | Error (°) | Histéresis (°) | |
|---|---|---|---|---|---|---|---|
| 0 | 500 | 1874.3 | 1872.4 | -0.04 | -0.04 | 0.19 |  |
| 5 | 556 | 1828.0 | 1829.5 | 4.40 | -0.60 | 0.15 |  |
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
| 72 | 1300 | 1149.7 | 1150.2 | 71.92 | -0.08 | 0.05 |  |
| 74 | 1322 | 1132.5 | 1124.4 | 74.06 | +0.06 | 0.81 |  |
| 76 | 1344 | 1111.2 | 1109.8 | 75.85 | -0.15 | 0.14 |  |
| 78 | 1367 | 1086.8 | 1088.3 | 78.13 | +0.13 | 0.15 |  |
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
| 170 | 2389 | 193.4 | 193.0 | 167.10 | -2.90 | 0.04 | fuera |
| 172 | 2411 | 193.3 | 193.7 | 167.07 | -4.93 | 0.04 | fuera |
| 174 | 2433 | 193.2 | 193.0 | 167.11 | -6.89 | 0.02 | fuera |
| 175 | 2444 | 193.2 | 193.4 | 167.09 | -7.91 | 0.02 | fuera |

## Avisos

- Fuera del rango útil (llegó a su tope o no siguió el comando): 170, 172, 174, 175°.
