flkochu/Arca9/datos/2026-10-29_eficiencia_12_servos/canal3/tabla.md

# Canal 3 · FR abducción

- Rango útil: 0° a 168° (500–2367 µs), 185–1888 mV en el pin
- Recta: ángulo = -0.09853·mV +185.73  (10.15 mV por grado), R² = 0.99996
- Error con la recta: RMS 0.30°, máx 0.98°, 100 % de los puntos dentro de ±1°
- Error con la tabla (de 2 en 2°, probada con otras pasadas): RMS 0.22°, máx 0.54°, 100 % dentro de ±1°
- Histéresis: máx 0.77°, media 0.20°
- Ruido con el servo quieto: σ 6.40 mV = 0.631°
- Por pasada (recta de cada una contra la de todos los datos):
  - de 30 en 30°: 12 puntos, R² 0.99999, se separa hasta 0.16°, error RMS 0.23°
  - de 20 en 20°: 18 puntos, R² 0.99997, se separa hasta 0.16°, error RMS 0.32°
  - de 10 en 10°: 34 puntos, R² 0.99997, se separa hasta 0.03°, error RMS 0.29°
  - de 5 en 5°: 68 puntos, R² 0.99996, se separa hasta 0.03°, error RMS 0.31°
  - de 2 en 2°: 170 puntos, R² 0.99996, se separa hasta 0.02°, error RMS 0.31°

## Pasada 1: de 30 en 30°

| Ángulo (°) | Pulso (µs) | mV ↑ | mV ↓ | Medido (°) | Error (°) | Histéresis (°) | |
|---|---|---|---|---|---|---|---|
| 0 | 500 | 1885.2 | 1885.5 | -0.03 | -0.03 | 0.03 |  |
| 30 | 833 | 1584.2 | 1581.2 | 29.79 | -0.21 | 0.30 |  |
| 60 | 1167 | 1278.3 | 1276.8 | 59.86 | -0.14 | 0.15 |  |
| 90 | 1500 | 974.5 | 969.9 | 89.94 | -0.06 | 0.45 |  |
| 120 | 1833 | 671.6 | 666.9 | 119.79 | -0.21 | 0.46 |  |
| 150 | 2167 | 366.5 | 361.2 | 149.88 | -0.12 | 0.52 |  |
| 175 | 2444 | 183.9 | 183.9 | 167.61 | -7.39 | 0.00 | fuera |

## Pasada 2: de 20 en 20°

| Ángulo (°) | Pulso (µs) | mV ↑ | mV ↓ | Medido (°) | Error (°) | Histéresis (°) | |
|---|---|---|---|---|---|---|---|
| 0 | 500 | 1885.9 | 1884.8 | -0.03 | -0.03 | 0.11 |  |
| 20 | 722 | 1681.8 | 1683.4 | 19.95 | -0.05 | 0.16 |  |
| 40 | 944 | 1476.2 | 1480.7 | 40.06 | +0.06 | 0.44 |  |
| 60 | 1167 | 1275.5 | 1274.0 | 60.13 | +0.13 | 0.15 |  |
| 80 | 1389 | 1070.0 | 1069.9 | 80.31 | +0.31 | 0.01 |  |
| 100 | 1611 | 863.8 | 865.3 | 100.55 | +0.55 | 0.15 |  |
| 120 | 1833 | 667.0 | 666.8 | 120.02 | +0.02 | 0.02 |  |
| 140 | 2056 | 463.1 | 463.7 | 140.07 | +0.07 | 0.06 |  |
| 160 | 2278 | 268.9 | 266.0 | 159.38 | -0.62 | 0.29 |  |
| 175 | 2444 | 188.5 | 188.6 | 167.15 | -7.85 | 0.01 | fuera |

## Pasada 3: de 10 en 10°

| Ángulo (°) | Pulso (µs) | mV ↑ | mV ↓ | Medido (°) | Error (°) | Histéresis (°) | |
|---|---|---|---|---|---|---|---|
| 0 | 500 | 1883.3 | 1886.4 | 0.02 | +0.02 | 0.31 |  |
| 10 | 611 | 1787.6 | 1784.9 | 9.74 | -0.26 | 0.27 |  |
| 20 | 722 | 1683.3 | 1685.2 | 19.79 | -0.21 | 0.19 |  |
| 30 | 833 | 1583.0 | 1581.8 | 29.82 | -0.18 | 0.12 |  |
| 40 | 944 | 1478.4 | 1476.9 | 40.14 | +0.14 | 0.15 |  |
| 50 | 1056 | 1373.6 | 1376.0 | 50.28 | +0.28 | 0.24 |  |
| 60 | 1167 | 1277.3 | 1275.2 | 59.98 | -0.02 | 0.21 |  |
| 70 | 1278 | 1170.9 | 1173.5 | 70.24 | +0.24 | 0.26 |  |
| 80 | 1389 | 1070.3 | 1069.7 | 80.31 | +0.31 | 0.06 |  |
| 90 | 1500 | 974.1 | 971.5 | 89.88 | -0.12 | 0.26 |  |
| 100 | 1611 | 865.4 | 864.9 | 100.49 | +0.49 | 0.05 |  |
| 110 | 1722 | 764.4 | 764.0 | 110.43 | +0.43 | 0.04 |  |
| 120 | 1833 | 668.3 | 667.0 | 119.95 | -0.05 | 0.13 |  |
| 130 | 1944 | 570.6 | 567.9 | 129.64 | -0.36 | 0.27 |  |
| 140 | 2056 | 465.5 | 462.1 | 140.03 | +0.03 | 0.33 |  |
| 150 | 2167 | 361.8 | 360.3 | 150.16 | +0.16 | 0.15 |  |
| 160 | 2278 | 266.6 | 266.0 | 159.49 | -0.51 | 0.06 |  |
| 170 | 2389 | 182.6 | 182.3 | 167.75 | -2.25 | 0.03 | fuera |
| 175 | 2444 | 182.1 | 181.8 | 167.80 | -7.20 | 0.03 | fuera |

## Pasada 4: de 5 en 5°

| Ángulo (°) | Pulso (µs) | mV ↑ | mV ↓ | Medido (°) | Error (°) | Histéresis (°) | |
|---|---|---|---|---|---|---|---|
| 0 | 500 | 1885.8 | 1886.6 | -0.11 | -0.11 | 0.08 |  |
| 5 | 556 | 1836.9 | 1836.5 | 4.77 | -0.23 | 0.04 |  |
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
| 72 | 1300 | 1155.2 | 1155.8 | 71.88 | -0.12 | 0.06 |  |
| 74 | 1322 | 1134.2 | 1134.5 | 73.97 | -0.03 | 0.03 |  |
| 76 | 1344 | 1114.1 | 1111.3 | 76.10 | +0.10 | 0.28 |  |
| 78 | 1367 | 1092.2 | 1092.6 | 78.10 | +0.10 | 0.04 |  |
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
| 170 | 2389 | 185.4 | 184.5 | 167.51 | -2.49 | 0.09 | fuera |
| 172 | 2411 | 185.7 | 185.3 | 167.45 | -4.55 | 0.04 | fuera |
| 174 | 2433 | 185.7 | 185.2 | 167.46 | -6.54 | 0.05 | fuera |
| 175 | 2444 | 185.3 | 185.3 | 167.47 | -7.53 | 0.00 | fuera |

## Avisos

- Fuera del rango útil (llegó a su tope o no siguió el comando): 170, 172, 174, 175°.
