flkochu/Arca9/datos/2026-10-29_eficiencia_12_servos/canal4/tabla.md

# Canal 4 · FR cadera

- Rango útil: 0° a 168° (500–2367 µs), 182–1870 mV en el pin
- Recta: ángulo = -0.09935·mV +185.62  (10.07 mV por grado), R² = 0.99996
- Error con la recta: RMS 0.31°, máx 0.98°, 100 % de los puntos dentro de ±1°
- Error con la tabla (de 2 en 2°, probada con otras pasadas): RMS 0.19°, máx 0.58°, 100 % dentro de ±1°
- Histéresis: máx 0.74°, media 0.19°
- Ruido con el servo quieto: σ 6.42 mV = 0.637°
- Por pasada (recta de cada una contra la de todos los datos):
  - de 30 en 30°: 12 puntos, R² 0.99998, se separa hasta 0.16°, error RMS 0.25°
  - de 20 en 20°: 18 puntos, R² 0.99997, se separa hasta 0.10°, error RMS 0.27°
  - de 10 en 10°: 34 puntos, R² 0.99997, se separa hasta 0.03°, error RMS 0.26°
  - de 5 en 5°: 68 puntos, R² 0.99997, se separa hasta 0.01°, error RMS 0.28°
  - de 2 en 2°: 170 puntos, R² 0.99995, se separa hasta 0.03°, error RMS 0.34°

## Pasada 1: de 30 en 30°

| Ángulo (°) | Pulso (µs) | mV ↑ | mV ↓ | Medido (°) | Error (°) | Histéresis (°) | |
|---|---|---|---|---|---|---|---|
| 0 | 500 | 1866.8 | 1865.5 | 0.22 | +0.22 | 0.13 |  |
| 30 | 833 | 1567.4 | 1567.0 | 29.92 | -0.08 | 0.04 |  |
| 60 | 1167 | 1262.2 | 1266.4 | 60.01 | +0.01 | 0.42 |  |
| 90 | 1500 | 958.7 | 956.7 | 90.47 | +0.47 | 0.20 |  |
| 120 | 1833 | 662.0 | 662.3 | 119.84 | -0.16 | 0.03 |  |
| 150 | 2167 | 360.1 | 359.5 | 149.88 | -0.12 | 0.06 |  |
| 175 | 2444 | 184.9 | 184.8 | 167.26 | -7.74 | 0.01 | fuera |

## Pasada 2: de 20 en 20°

| Ángulo (°) | Pulso (µs) | mV ↑ | mV ↓ | Medido (°) | Error (°) | Histéresis (°) | |
|---|---|---|---|---|---|---|---|
| 0 | 500 | 1866.0 | 1866.3 | 0.22 | +0.22 | 0.03 |  |
| 20 | 722 | 1671.4 | 1667.6 | 19.75 | -0.25 | 0.38 |  |
| 40 | 944 | 1464.4 | 1466.2 | 40.04 | +0.04 | 0.18 |  |
| 60 | 1167 | 1262.0 | 1265.9 | 60.05 | +0.05 | 0.39 |  |
| 80 | 1389 | 1060.8 | 1064.4 | 80.05 | +0.05 | 0.36 |  |
| 100 | 1611 | 858.3 | 857.3 | 100.40 | +0.40 | 0.10 |  |
| 120 | 1833 | 661.8 | 661.4 | 119.89 | -0.11 | 0.04 |  |
| 140 | 2056 | 459.4 | 456.9 | 140.10 | +0.10 | 0.25 |  |
| 160 | 2278 | 264.3 | 259.5 | 159.60 | -0.40 | 0.48 |  |
| 175 | 2444 | 183.5 | 183.7 | 167.38 | -7.62 | 0.02 | fuera |

## Pasada 3: de 10 en 10°

| Ángulo (°) | Pulso (µs) | mV ↑ | mV ↓ | Medido (°) | Error (°) | Histéresis (°) | |
|---|---|---|---|---|---|---|---|
| 0 | 500 | 1866.4 | 1868.9 | 0.07 | +0.07 | 0.25 |  |
| 10 | 611 | 1769.9 | 1769.8 | 9.78 | -0.22 | 0.01 |  |
| 20 | 722 | 1670.9 | 1669.2 | 19.70 | -0.30 | 0.17 |  |
| 30 | 833 | 1569.2 | 1566.2 | 29.87 | -0.13 | 0.30 |  |
| 40 | 944 | 1467.1 | 1464.7 | 39.98 | -0.02 | 0.24 |  |
| 50 | 1056 | 1365.0 | 1364.3 | 50.04 | +0.04 | 0.07 |  |
| 60 | 1167 | 1266.8 | 1264.0 | 59.90 | -0.10 | 0.28 |  |
| 70 | 1278 | 1161.0 | 1162.1 | 70.22 | +0.22 | 0.11 |  |
| 80 | 1389 | 1059.3 | 1060.2 | 80.33 | +0.33 | 0.09 |  |
| 90 | 1500 | 960.3 | 959.8 | 90.24 | +0.24 | 0.05 |  |
| 100 | 1611 | 857.6 | 858.4 | 100.38 | +0.38 | 0.08 |  |
| 110 | 1722 | 760.0 | 754.8 | 110.37 | +0.37 | 0.52 |  |
| 120 | 1833 | 662.4 | 663.7 | 119.75 | -0.25 | 0.13 |  |
| 130 | 1944 | 561.7 | 558.5 | 129.98 | -0.02 | 0.32 |  |
| 140 | 2056 | 460.6 | 457.0 | 140.04 | +0.04 | 0.36 |  |
| 150 | 2167 | 359.1 | 358.3 | 149.99 | -0.01 | 0.08 |  |
| 160 | 2278 | 262.9 | 262.5 | 159.52 | -0.48 | 0.04 |  |
| 170 | 2389 | 182.4 | 182.4 | 167.50 | -2.50 | 0.00 | fuera |
| 175 | 2444 | 182.1 | 181.6 | 167.56 | -7.44 | 0.05 | fuera |

## Pasada 4: de 5 en 5°

| Ángulo (°) | Pulso (µs) | mV ↑ | mV ↓ | Medido (°) | Error (°) | Histéresis (°) | |
|---|---|---|---|---|---|---|---|
| 0 | 500 | 1869.0 | 1865.3 | 0.12 | +0.12 | 0.37 |  |
| 5 | 556 | 1820.1 | 1820.8 | 4.76 | -0.24 | 0.07 |  |
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
| 72 | 1300 | 1144.3 | 1144.2 | 71.94 | -0.06 | 0.01 |  |
| 74 | 1322 | 1121.3 | 1123.1 | 74.13 | +0.13 | 0.18 |  |
| 76 | 1344 | 1107.3 | 1104.9 | 75.73 | -0.27 | 0.24 |  |
| 78 | 1367 | 1080.8 | 1080.8 | 78.24 | +0.24 | 0.00 |  |
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
| 170 | 2389 | 182.4 | 182.1 | 167.52 | -2.48 | 0.03 | fuera |
| 172 | 2411 | 182.2 | 182.3 | 167.52 | -4.48 | 0.01 | fuera |
| 174 | 2433 | 181.8 | 181.5 | 167.58 | -6.42 | 0.03 | fuera |
| 175 | 2444 | 182.2 | 181.4 | 167.56 | -7.44 | 0.08 | fuera |

## Avisos

- Fuera del rango útil (llegó a su tope o no siguió el comando): 170, 172, 174, 175°.
