flkochu/Arca9/datos/2026-10-29_eficiencia_12_servos/canal5/tabla.md

# Canal 5 · FR rodilla

- Rango útil: 0° a 168° (500–2367 µs), 187–1888 mV en el pin
- Recta: ángulo = -0.09860·mV +185.95  (10.14 mV por grado), R² = 0.99996
- Error con la recta: RMS 0.32°, máx 0.95°, 100 % de los puntos dentro de ±1°
- Error con la tabla (de 2 en 2°, probada con otras pasadas): RMS 0.21°, máx 0.60°, 100 % dentro de ±1°
- Histéresis: máx 0.70°, media 0.24°
- Ruido con el servo quieto: σ 7.20 mV = 0.709°
- Por pasada (recta de cada una contra la de todos los datos):
  - de 30 en 30°: 12 puntos, R² 0.99999, se separa hasta 0.27°, error RMS 0.20°
  - de 20 en 20°: 18 puntos, R² 0.99997, se separa hasta 0.13°, error RMS 0.29°
  - de 10 en 10°: 34 puntos, R² 0.99996, se separa hasta 0.07°, error RMS 0.30°
  - de 5 en 5°: 68 puntos, R² 0.99997, se separa hasta 0.04°, error RMS 0.28°
  - de 2 en 2°: 170 puntos, R² 0.99995, se separa hasta 0.03°, error RMS 0.35°

## Pasada 1: de 30 en 30°

| Ángulo (°) | Pulso (µs) | mV ↑ | mV ↓ | Medido (°) | Error (°) | Histéresis (°) | |
|---|---|---|---|---|---|---|---|
| 0 | 500 | 1885.2 | 1885.6 | 0.04 | +0.04 | 0.04 |  |
| 30 | 833 | 1582.5 | 1582.9 | 29.89 | -0.11 | 0.04 |  |
| 60 | 1167 | 1277.4 | 1275.9 | 60.07 | +0.07 | 0.15 |  |
| 90 | 1500 | 977.1 | 974.0 | 89.76 | -0.24 | 0.31 |  |
| 120 | 1833 | 673.3 | 670.0 | 119.72 | -0.28 | 0.33 |  |
| 150 | 2167 | 366.8 | 365.4 | 149.85 | -0.15 | 0.14 |  |
| 175 | 2444 | 183.8 | 183.9 | 167.82 | -7.18 | 0.01 | fuera |

## Pasada 2: de 20 en 20°

| Ángulo (°) | Pulso (µs) | mV ↑ | mV ↓ | Medido (°) | Error (°) | Histéresis (°) | |
|---|---|---|---|---|---|---|---|
| 0 | 500 | 1885.3 | 1885.5 | 0.04 | +0.04 | 0.02 |  |
| 20 | 722 | 1684.0 | 1682.4 | 19.98 | -0.02 | 0.16 |  |
| 40 | 944 | 1481.3 | 1480.5 | 39.93 | -0.07 | 0.08 |  |
| 60 | 1167 | 1277.3 | 1275.7 | 60.08 | +0.08 | 0.16 |  |
| 80 | 1389 | 1071.2 | 1069.8 | 80.39 | +0.39 | 0.14 |  |
| 100 | 1611 | 867.1 | 868.7 | 100.37 | +0.37 | 0.16 |  |
| 120 | 1833 | 671.8 | 666.1 | 119.99 | -0.01 | 0.56 |  |
| 140 | 2056 | 466.6 | 462.8 | 140.13 | +0.13 | 0.37 |  |
| 160 | 2278 | 270.3 | 265.9 | 159.51 | -0.49 | 0.43 |  |
| 175 | 2444 | 184.7 | 184.1 | 167.77 | -7.23 | 0.06 | fuera |

## Pasada 3: de 10 en 10°

| Ángulo (°) | Pulso (µs) | mV ↑ | mV ↓ | Medido (°) | Error (°) | Histéresis (°) | |
|---|---|---|---|---|---|---|---|
| 0 | 500 | 1886.3 | 1883.2 | 0.11 | +0.11 | 0.31 |  |
| 10 | 611 | 1789.0 | 1791.0 | 9.45 | -0.55 | 0.20 |  |
| 20 | 722 | 1685.6 | 1683.5 | 19.85 | -0.15 | 0.21 |  |
| 30 | 833 | 1585.8 | 1581.7 | 29.79 | -0.21 | 0.40 |  |
| 40 | 944 | 1481.0 | 1480.7 | 39.93 | -0.07 | 0.03 |  |
| 50 | 1056 | 1377.7 | 1379.4 | 50.02 | +0.02 | 0.17 |  |
| 60 | 1167 | 1276.2 | 1274.7 | 60.19 | +0.19 | 0.15 |  |
| 70 | 1278 | 1173.8 | 1171.2 | 70.34 | +0.34 | 0.26 |  |
| 80 | 1389 | 1071.0 | 1070.9 | 80.35 | +0.35 | 0.01 |  |
| 90 | 1500 | 976.2 | 976.6 | 89.67 | -0.33 | 0.04 |  |
| 100 | 1611 | 869.5 | 869.3 | 100.22 | +0.22 | 0.02 |  |
| 110 | 1722 | 767.5 | 767.2 | 110.29 | +0.29 | 0.03 |  |
| 120 | 1833 | 668.8 | 670.7 | 119.91 | -0.09 | 0.19 |  |
| 130 | 1944 | 572.9 | 570.4 | 129.58 | -0.42 | 0.25 |  |
| 140 | 2056 | 465.2 | 465.2 | 140.08 | +0.08 | 0.00 |  |
| 150 | 2167 | 367.6 | 363.7 | 149.89 | -0.11 | 0.38 |  |
| 160 | 2278 | 268.6 | 267.2 | 159.53 | -0.47 | 0.14 |  |
| 170 | 2389 | 182.6 | 181.8 | 167.98 | -2.02 | 0.08 | fuera |
| 175 | 2444 | 182.1 | 181.8 | 168.01 | -6.99 | 0.03 | fuera |

## Pasada 4: de 5 en 5°

| Ángulo (°) | Pulso (µs) | mV ↑ | mV ↓ | Medido (°) | Error (°) | Histéresis (°) | |
|---|---|---|---|---|---|---|---|
| 0 | 500 | 1883.6 | 1887.3 | 0.04 | +0.04 | 0.36 |  |
| 5 | 556 | 1836.4 | 1837.5 | 4.82 | -0.18 | 0.11 |  |
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
| 72 | 1300 | 1155.3 | 1155.8 | 72.01 | +0.01 | 0.05 |  |
| 74 | 1322 | 1133.2 | 1132.5 | 74.25 | +0.25 | 0.07 |  |
| 76 | 1344 | 1116.2 | 1110.7 | 76.16 | +0.16 | 0.54 |  |
| 78 | 1367 | 1093.7 | 1090.7 | 78.25 | +0.25 | 0.30 |  |
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
| 170 | 2389 | 187.3 | 187.0 | 167.49 | -2.51 | 0.03 | fuera |
| 172 | 2411 | 187.3 | 187.3 | 167.48 | -4.52 | 0.00 | fuera |
| 174 | 2433 | 186.9 | 186.7 | 167.53 | -6.47 | 0.02 | fuera |
| 175 | 2444 | 186.8 | 187.8 | 167.48 | -7.52 | 0.10 | fuera |

## Avisos

- Fuera del rango útil (llegó a su tope o no siguió el comando): 170, 172, 174, 175°.
