flkochu/Arca9/datos/2026-10-29_eficiencia_12_servos/canal6/tabla.md

# Canal 6 · RL abducción

- Rango útil: 0° a 170° (500–2389 µs), 180–1867 mV en el pin
- Recta: ángulo = -0.09992·mV +186.37  (10.01 mV por grado), R² = 0.99994
- Error con la recta: RMS 0.39°, máx 1.93°, 98 % de los puntos dentro de ±1°
- Error con la tabla (de 2 en 2°, probada con otras pasadas): RMS 0.21°, máx 1.01°, 99 % dentro de ±1°
- Histéresis: máx 0.76°, media 0.19°
- Ruido con el servo quieto: σ 6.13 mV = 0.612°
- Por pasada (recta de cada una contra la de todos los datos):
  - de 30 en 30°: 12 puntos, R² 0.99999, se separa hasta 0.25°, error RMS 0.21°
  - de 20 en 20°: 18 puntos, R² 0.99997, se separa hasta 0.18°, error RMS 0.29°
  - de 10 en 10°: 36 puntos, R² 0.99992, se separa hasta 0.22°, error RMS 0.48°
  - de 5 en 5°: 70 puntos, R² 0.99993, se separa hasta 0.12°, error RMS 0.42°
  - de 2 en 2°: 172 puntos, R² 0.99994, se separa hasta 0.07°, error RMS 0.38°

## Pasada 1: de 30 en 30°

| Ángulo (°) | Pulso (µs) | mV ↑ | mV ↓ | Medido (°) | Error (°) | Histéresis (°) | |
|---|---|---|---|---|---|---|---|
| 0 | 500 | 1864.6 | 1866.0 | -0.00 | -0.00 | 0.14 |  |
| 30 | 833 | 1565.4 | 1566.3 | 29.92 | -0.08 | 0.09 |  |
| 60 | 1167 | 1262.4 | 1263.7 | 60.17 | +0.17 | 0.13 |  |
| 90 | 1500 | 964.0 | 958.9 | 90.31 | +0.31 | 0.51 |  |
| 120 | 1833 | 662.0 | 663.1 | 120.17 | +0.17 | 0.11 |  |
| 150 | 2167 | 363.0 | 362.8 | 150.11 | +0.11 | 0.02 |  |
| 175 | 2444 | 182.7 | 183.1 | 168.10 | -6.90 | 0.04 | fuera |

## Pasada 2: de 20 en 20°

| Ángulo (°) | Pulso (µs) | mV ↑ | mV ↓ | Medido (°) | Error (°) | Histéresis (°) | |
|---|---|---|---|---|---|---|---|
| 0 | 500 | 1865.0 | 1867.0 | -0.07 | -0.07 | 0.20 |  |
| 20 | 722 | 1670.3 | 1666.9 | 19.65 | -0.35 | 0.34 |  |
| 40 | 944 | 1464.7 | 1465.9 | 39.97 | -0.03 | 0.12 |  |
| 60 | 1167 | 1264.8 | 1265.1 | 59.98 | -0.02 | 0.03 |  |
| 80 | 1389 | 1062.9 | 1059.0 | 80.37 | +0.37 | 0.39 |  |
| 100 | 1611 | 862.0 | 858.8 | 100.41 | +0.41 | 0.32 |  |
| 120 | 1833 | 661.8 | 661.5 | 120.26 | +0.26 | 0.03 |  |
| 140 | 2056 | 460.6 | 464.6 | 140.15 | +0.15 | 0.40 |  |
| 160 | 2278 | 266.7 | 266.8 | 159.72 | -0.28 | 0.01 |  |
| 175 | 2444 | 184.0 | 182.9 | 168.04 | -6.96 | 0.11 | fuera |

## Pasada 3: de 10 en 10°

| Ángulo (°) | Pulso (µs) | mV ↑ | mV ↓ | Medido (°) | Error (°) | Histéresis (°) | |
|---|---|---|---|---|---|---|---|
| 0 | 500 | 1866.7 | 1864.3 | -0.02 | -0.02 | 0.24 |  |
| 10 | 611 | 1768.4 | 1764.6 | 9.87 | -0.13 | 0.38 |  |
| 20 | 722 | 1668.9 | 1664.8 | 19.83 | -0.17 | 0.41 |  |
| 30 | 833 | 1567.7 | 1565.4 | 29.85 | -0.15 | 0.23 |  |
| 40 | 944 | 1464.9 | 1466.7 | 39.92 | -0.08 | 0.18 |  |
| 50 | 1056 | 1366.7 | 1364.1 | 49.95 | -0.05 | 0.26 |  |
| 60 | 1167 | 1262.1 | 1264.3 | 60.16 | +0.16 | 0.22 |  |
| 70 | 1278 | 1164.8 | 1162.7 | 70.10 | +0.10 | 0.21 |  |
| 80 | 1389 | 1061.8 | 1059.4 | 80.40 | +0.40 | 0.24 |  |
| 90 | 1500 | 960.9 | 964.6 | 90.18 | +0.18 | 0.37 |  |
| 100 | 1611 | 860.4 | 858.5 | 100.50 | +0.50 | 0.19 |  |
| 110 | 1722 | 760.2 | 760.0 | 110.43 | +0.43 | 0.02 |  |
| 120 | 1833 | 662.6 | 663.2 | 120.14 | +0.14 | 0.06 |  |
| 130 | 1944 | 566.8 | 563.9 | 129.89 | -0.11 | 0.29 |  |
| 140 | 2056 | 467.6 | 460.0 | 140.03 | +0.03 | 0.76 |  |
| 150 | 2167 | 363.1 | 362.3 | 150.13 | +0.13 | 0.08 |  |
| 160 | 2278 | 266.0 | 268.3 | 159.68 | -0.32 | 0.23 |  |
| 170 | 2389 | 181.3 | 180.8 | 168.28 | -1.72 | 0.05 |  |
| 175 | 2444 | 181.4 | 181.6 | 168.24 | -6.76 | 0.02 | fuera |

## Pasada 4: de 5 en 5°

| Ángulo (°) | Pulso (µs) | mV ↑ | mV ↓ | Medido (°) | Error (°) | Histéresis (°) | |
|---|---|---|---|---|---|---|---|
| 0 | 500 | 1864.2 | 1866.5 | -0.01 | -0.01 | 0.23 |  |
| 5 | 556 | 1820.0 | 1818.9 | 4.58 | -0.42 | 0.11 |  |
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
| 72 | 1300 | 1146.5 | 1145.8 | 71.85 | -0.15 | 0.07 |  |
| 74 | 1322 | 1122.9 | 1123.4 | 74.15 | +0.15 | 0.05 |  |
| 76 | 1344 | 1107.8 | 1105.9 | 75.78 | -0.22 | 0.19 |  |
| 78 | 1367 | 1083.1 | 1085.4 | 78.04 | +0.04 | 0.23 |  |
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
| 172 | 2411 | 180.2 | 180.2 | 168.37 | -3.63 | 0.00 | fuera |
| 174 | 2433 | 179.8 | 180.5 | 168.37 | -5.63 | 0.07 | fuera |
| 175 | 2444 | 180.8 | 180.3 | 168.33 | -6.67 | 0.05 | fuera |

## Avisos

- Fuera del rango útil (llegó a su tope o no siguió el comando): 172, 174, 175°.
