flkochu/Arca9/datos/2026-10-29_eficiencia_12_servos/canal7/tabla.md

# Canal 7 · RL cadera

- Rango útil: 0° a 168° (500–2367 µs), 187–1879 mV en el pin
- Recta: ángulo = -0.09898·mV +185.88  (10.10 mV por grado), R² = 0.99996
- Error con la recta: RMS 0.32°, máx 0.93°, 100 % de los puntos dentro de ±1°
- Error con la tabla (de 2 en 2°, probada con otras pasadas): RMS 0.20°, máx 0.50°, 100 % dentro de ±1°
- Histéresis: máx 0.71°, media 0.21°
- Ruido con el servo quieto: σ 6.44 mV = 0.637°
- Por pasada (recta de cada una contra la de todos los datos):
  - de 30 en 30°: 12 puntos, R² 0.99999, se separa hasta 0.22°, error RMS 0.17°
  - de 20 en 20°: 18 puntos, R² 0.99997, se separa hasta 0.05°, error RMS 0.28°
  - de 10 en 10°: 34 puntos, R² 0.99997, se separa hasta 0.11°, error RMS 0.27°
  - de 5 en 5°: 68 puntos, R² 0.99995, se separa hasta 0.05°, error RMS 0.34°
  - de 2 en 2°: 170 puntos, R² 0.99995, se separa hasta 0.02°, error RMS 0.34°

## Pasada 1: de 30 en 30°

| Ángulo (°) | Pulso (µs) | mV ↑ | mV ↓ | Medido (°) | Error (°) | Histéresis (°) | |
|---|---|---|---|---|---|---|---|
| 0 | 500 | 1877.4 | 1876.7 | 0.10 | +0.10 | 0.07 |  |
| 30 | 833 | 1577.1 | 1575.3 | 29.87 | -0.13 | 0.18 |  |
| 60 | 1167 | 1272.5 | 1271.4 | 59.99 | -0.01 | 0.11 |  |
| 90 | 1500 | 967.3 | 968.7 | 90.07 | +0.07 | 0.14 |  |
| 120 | 1833 | 666.7 | 666.0 | 119.93 | -0.07 | 0.07 |  |
| 150 | 2167 | 366.9 | 364.7 | 149.68 | -0.32 | 0.22 |  |
| 175 | 2444 | 183.4 | 183.2 | 167.74 | -7.26 | 0.02 | fuera |

## Pasada 2: de 20 en 20°

| Ángulo (°) | Pulso (µs) | mV ↑ | mV ↓ | Medido (°) | Error (°) | Histéresis (°) | |
|---|---|---|---|---|---|---|---|
| 0 | 500 | 1878.1 | 1877.0 | 0.05 | +0.05 | 0.11 |  |
| 20 | 722 | 1676.9 | 1681.2 | 19.70 | -0.30 | 0.43 |  |
| 40 | 944 | 1474.8 | 1475.6 | 39.87 | -0.13 | 0.08 |  |
| 60 | 1167 | 1271.5 | 1271.8 | 60.02 | +0.02 | 0.03 |  |
| 80 | 1389 | 1066.3 | 1068.7 | 80.23 | +0.23 | 0.24 |  |
| 100 | 1611 | 863.7 | 862.1 | 100.48 | +0.48 | 0.16 |  |
| 120 | 1833 | 669.0 | 665.4 | 119.85 | -0.15 | 0.36 |  |
| 140 | 2056 | 463.8 | 462.0 | 140.07 | +0.07 | 0.18 |  |
| 160 | 2278 | 266.6 | 265.2 | 159.57 | -0.43 | 0.14 |  |
| 175 | 2444 | 183.8 | 182.6 | 167.75 | -7.25 | 0.12 | fuera |

## Pasada 3: de 10 en 10°

| Ángulo (°) | Pulso (µs) | mV ↑ | mV ↓ | Medido (°) | Error (°) | Histéresis (°) | |
|---|---|---|---|---|---|---|---|
| 0 | 500 | 1876.2 | 1877.9 | 0.10 | +0.10 | 0.17 |  |
| 10 | 611 | 1778.4 | 1779.7 | 9.80 | -0.20 | 0.13 |  |
| 20 | 722 | 1680.3 | 1678.3 | 19.67 | -0.33 | 0.20 |  |
| 30 | 833 | 1578.4 | 1574.9 | 29.83 | -0.17 | 0.35 |  |
| 40 | 944 | 1476.9 | 1473.2 | 39.89 | -0.11 | 0.37 |  |
| 50 | 1056 | 1372.1 | 1369.5 | 50.21 | +0.21 | 0.26 |  |
| 60 | 1167 | 1273.5 | 1271.6 | 59.93 | -0.07 | 0.19 |  |
| 70 | 1278 | 1172.1 | 1168.8 | 70.04 | +0.04 | 0.33 |  |
| 80 | 1389 | 1068.6 | 1067.7 | 80.16 | +0.16 | 0.09 |  |
| 90 | 1500 | 967.9 | 966.0 | 90.18 | +0.18 | 0.19 |  |
| 100 | 1611 | 861.7 | 863.9 | 100.49 | +0.49 | 0.22 |  |
| 110 | 1722 | 760.5 | 763.4 | 110.47 | +0.47 | 0.29 |  |
| 120 | 1833 | 665.8 | 665.2 | 120.01 | +0.01 | 0.06 |  |
| 130 | 1944 | 567.4 | 561.3 | 130.03 | +0.03 | 0.60 |  |
| 140 | 2056 | 461.4 | 462.0 | 140.19 | +0.19 | 0.06 |  |
| 150 | 2167 | 364.0 | 363.1 | 149.90 | -0.10 | 0.09 |  |
| 160 | 2278 | 266.0 | 264.5 | 159.63 | -0.37 | 0.15 |  |
| 170 | 2389 | 182.4 | 183.0 | 167.80 | -2.20 | 0.06 | fuera |
| 175 | 2444 | 182.4 | 182.7 | 167.82 | -7.18 | 0.03 | fuera |

## Pasada 4: de 5 en 5°

| Ángulo (°) | Pulso (µs) | mV ↑ | mV ↓ | Medido (°) | Error (°) | Histéresis (°) | |
|---|---|---|---|---|---|---|---|
| 0 | 500 | 1877.7 | 1878.6 | -0.01 | -0.01 | 0.09 |  |
| 5 | 556 | 1832.6 | 1830.0 | 4.63 | -0.37 | 0.26 |  |
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
| 72 | 1300 | 1154.4 | 1150.6 | 71.81 | -0.19 | 0.38 |  |
| 74 | 1322 | 1128.2 | 1128.0 | 74.23 | +0.23 | 0.02 |  |
| 76 | 1344 | 1111.7 | 1108.5 | 76.01 | +0.01 | 0.32 |  |
| 78 | 1367 | 1090.5 | 1089.9 | 77.98 | -0.02 | 0.06 |  |
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
| 170 | 2389 | 187.4 | 187.7 | 167.32 | -2.68 | 0.03 | fuera |
| 172 | 2411 | 187.8 | 187.5 | 167.31 | -4.69 | 0.03 | fuera |
| 174 | 2433 | 187.4 | 187.2 | 167.35 | -6.65 | 0.02 | fuera |
| 175 | 2444 | 187.8 | 187.6 | 167.31 | -7.69 | 0.02 | fuera |

## Avisos

- Fuera del rango útil (llegó a su tope o no siguió el comando): 170, 172, 174, 175°.
