flkochu/Arca9/datos/2026-10-29_eficiencia_12_servos/canal8/tabla.md

# Canal 8 · RL rodilla

- Rango útil: 0° a 170° (500–2389 µs), 179–1859 mV en el pin
- Recta: ángulo = -0.10060·mV +186.93  (9.94 mV por grado), R² = 0.99995
- Error con la recta: RMS 0.37°, máx 1.51°, 98 % de los puntos dentro de ±1°
- Error con la tabla (de 2 en 2°, probada con otras pasadas): RMS 0.21°, máx 0.75°, 100 % dentro de ±1°
- Histéresis: máx 0.71°, media 0.20°
- Ruido con el servo quieto: σ 6.35 mV = 0.638°
- Por pasada (recta de cada una contra la de todos los datos):
  - de 30 en 30°: 12 puntos, R² 0.99997, se separa hasta 0.13°, error RMS 0.28°
  - de 20 en 20°: 18 puntos, R² 0.99996, se separa hasta 0.13°, error RMS 0.33°
  - de 10 en 10°: 36 puntos, R² 0.99994, se separa hasta 0.29°, error RMS 0.43°
  - de 5 en 5°: 70 puntos, R² 0.99994, se separa hasta 0.07°, error RMS 0.39°
  - de 2 en 2°: 172 puntos, R² 0.99995, se separa hasta 0.04°, error RMS 0.36°

## Pasada 1: de 30 en 30°

| Ángulo (°) | Pulso (µs) | mV ↑ | mV ↓ | Medido (°) | Error (°) | Histéresis (°) | |
|---|---|---|---|---|---|---|---|
| 0 | 500 | 1855.5 | 1856.1 | 0.23 | +0.23 | 0.06 |  |
| 30 | 833 | 1563.4 | 1563.0 | 29.67 | -0.33 | 0.04 |  |
| 60 | 1167 | 1259.1 | 1263.9 | 60.02 | +0.02 | 0.48 |  |
| 90 | 1500 | 957.5 | 960.1 | 90.48 | +0.48 | 0.26 |  |
| 120 | 1833 | 664.4 | 664.1 | 120.11 | +0.11 | 0.03 |  |
| 150 | 2167 | 367.8 | 366.9 | 149.98 | -0.02 | 0.09 |  |
| 175 | 2444 | 180.0 | 179.2 | 168.87 | -6.13 | 0.08 | fuera |

## Pasada 2: de 20 en 20°

| Ángulo (°) | Pulso (µs) | mV ↑ | mV ↓ | Medido (°) | Error (°) | Histéresis (°) | |
|---|---|---|---|---|---|---|---|
| 0 | 500 | 1857.1 | 1856.8 | 0.12 | +0.12 | 0.03 |  |
| 20 | 722 | 1661.7 | 1660.0 | 19.85 | -0.15 | 0.17 |  |
| 40 | 944 | 1460.7 | 1461.7 | 39.93 | -0.07 | 0.10 |  |
| 60 | 1167 | 1261.7 | 1264.6 | 59.86 | -0.14 | 0.29 |  |
| 80 | 1389 | 1058.1 | 1057.5 | 80.52 | +0.52 | 0.06 |  |
| 100 | 1611 | 857.2 | 861.5 | 100.48 | +0.48 | 0.43 |  |
| 120 | 1833 | 662.6 | 664.7 | 120.17 | +0.17 | 0.21 |  |
| 140 | 2056 | 463.2 | 463.1 | 140.34 | +0.34 | 0.01 |  |
| 160 | 2278 | 272.3 | 271.4 | 159.59 | -0.41 | 0.09 |  |
| 175 | 2444 | 183.3 | 183.6 | 168.48 | -6.52 | 0.03 | fuera |

## Pasada 3: de 10 en 10°

| Ángulo (°) | Pulso (µs) | mV ↑ | mV ↓ | Medido (°) | Error (°) | Histéresis (°) | |
|---|---|---|---|---|---|---|---|
| 0 | 500 | 1857.0 | 1857.1 | 0.11 | +0.11 | 0.01 |  |
| 10 | 611 | 1759.7 | 1763.0 | 9.74 | -0.26 | 0.33 |  |
| 20 | 722 | 1660.8 | 1660.2 | 19.88 | -0.12 | 0.06 |  |
| 30 | 833 | 1561.7 | 1562.6 | 29.78 | -0.22 | 0.09 |  |
| 40 | 944 | 1459.3 | 1462.0 | 39.99 | -0.01 | 0.27 |  |
| 50 | 1056 | 1361.6 | 1363.2 | 49.87 | -0.13 | 0.16 |  |
| 60 | 1167 | 1261.8 | 1261.6 | 60.00 | +0.00 | 0.02 |  |
| 70 | 1278 | 1160.2 | 1161.0 | 70.17 | +0.17 | 0.08 |  |
| 80 | 1389 | 1062.2 | 1059.9 | 80.19 | +0.19 | 0.23 |  |
| 90 | 1500 | 960.8 | 961.6 | 90.23 | +0.23 | 0.08 |  |
| 100 | 1611 | 860.1 | 861.4 | 100.34 | +0.34 | 0.13 |  |
| 110 | 1722 | 762.3 | 758.7 | 110.43 | +0.43 | 0.36 |  |
| 120 | 1833 | 664.5 | 666.4 | 119.99 | -0.01 | 0.19 |  |
| 130 | 1944 | 566.8 | 567.4 | 129.88 | -0.12 | 0.06 |  |
| 140 | 2056 | 464.0 | 467.2 | 140.09 | +0.09 | 0.32 |  |
| 150 | 2167 | 368.4 | 366.4 | 149.97 | -0.03 | 0.20 |  |
| 160 | 2278 | 274.3 | 273.3 | 159.39 | -0.61 | 0.10 |  |
| 170 | 2389 | 183.3 | 183.0 | 168.51 | -1.49 | 0.03 |  |
| 175 | 2444 | 183.5 | 182.9 | 168.50 | -6.50 | 0.06 | fuera |

## Pasada 4: de 5 en 5°

| Ángulo (°) | Pulso (µs) | mV ↑ | mV ↓ | Medido (°) | Error (°) | Histéresis (°) | |
|---|---|---|---|---|---|---|---|
| 0 | 500 | 1858.6 | 1856.5 | 0.06 | +0.06 | 0.21 |  |
| 5 | 556 | 1815.8 | 1811.5 | 4.47 | -0.53 | 0.43 |  |
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
| 72 | 1300 | 1145.4 | 1144.4 | 71.75 | -0.25 | 0.10 |  |
| 74 | 1322 | 1122.4 | 1120.0 | 74.14 | +0.14 | 0.24 |  |
| 76 | 1344 | 1104.9 | 1103.6 | 75.84 | -0.16 | 0.13 |  |
| 78 | 1367 | 1081.4 | 1082.6 | 78.08 | +0.08 | 0.12 |  |
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
| 172 | 2411 | 179.6 | 180.0 | 168.85 | -3.15 | 0.04 | fuera |
| 174 | 2433 | 179.9 | 179.8 | 168.84 | -5.16 | 0.01 | fuera |
| 175 | 2444 | 179.7 | 179.9 | 168.85 | -6.15 | 0.02 | fuera |

## Avisos

- Fuera del rango útil (llegó a su tope o no siguió el comando): 172, 174, 175°.
