flkochu/Arca9/datos/2026-10-29_eficiencia_12_servos/canal9/tabla.md

# Canal 9 · RR abducción

- Rango útil: 0° a 168° (500–2367 µs), 181–1840 mV en el pin
- Recta: ángulo = -0.10086·mV +185.42  (9.91 mV por grado), R² = 0.99995
- Error con la recta: RMS 0.36°, máx 1.07°, 99 % de los puntos dentro de ±1°
- Error con la tabla (de 2 en 2°, probada con otras pasadas): RMS 0.24°, máx 0.66°, 100 % dentro de ±1°
- Histéresis: máx 0.84°, media 0.31°
- Ruido con el servo quieto: σ 5.96 mV = 0.601°
- Por pasada (recta de cada una contra la de todos los datos):
  - de 30 en 30°: 12 puntos, R² 0.99998, se separa hasta 0.14°, error RMS 0.23°
  - de 20 en 20°: 18 puntos, R² 0.99997, se separa hasta 0.08°, error RMS 0.30°
  - de 10 en 10°: 34 puntos, R² 0.99996, se separa hasta 0.06°, error RMS 0.31°
  - de 5 en 5°: 68 puntos, R² 0.99996, se separa hasta 0.06°, error RMS 0.32°
  - de 2 en 2°: 170 puntos, R² 0.99994, se separa hasta 0.05°, error RMS 0.39°

## Pasada 1: de 30 en 30°

| Ángulo (°) | Pulso (µs) | mV ↑ | mV ↓ | Medido (°) | Error (°) | Histéresis (°) | |
|---|---|---|---|---|---|---|---|
| 0 | 500 | 1838.5 | 1839.6 | -0.07 | -0.07 | 0.11 |  |
| 30 | 833 | 1544.8 | 1542.9 | 29.70 | -0.30 | 0.19 |  |
| 60 | 1167 | 1246.0 | 1244.8 | 59.80 | -0.20 | 0.12 |  |
| 90 | 1500 | 942.3 | 942.2 | 90.38 | +0.38 | 0.01 |  |
| 120 | 1833 | 649.8 | 649.3 | 119.90 | -0.10 | 0.05 |  |
| 150 | 2167 | 353.3 | 351.3 | 149.89 | -0.11 | 0.20 |  |
| 175 | 2444 | 184.5 | 184.7 | 166.80 | -8.20 | 0.02 | fuera |

## Pasada 2: de 20 en 20°

| Ángulo (°) | Pulso (µs) | mV ↑ | mV ↓ | Medido (°) | Error (°) | Histéresis (°) | |
|---|---|---|---|---|---|---|---|
| 0 | 500 | 1838.9 | 1837.1 | 0.03 | +0.03 | 0.18 |  |
| 20 | 722 | 1643.4 | 1642.1 | 19.73 | -0.27 | 0.13 |  |
| 40 | 944 | 1441.2 | 1441.2 | 40.06 | +0.06 | 0.00 |  |
| 60 | 1167 | 1246.0 | 1243.7 | 59.86 | -0.14 | 0.23 |  |
| 80 | 1389 | 1046.9 | 1041.1 | 80.12 | +0.12 | 0.59 |  |
| 100 | 1611 | 844.6 | 841.1 | 100.41 | +0.41 | 0.35 |  |
| 120 | 1833 | 648.8 | 646.4 | 120.10 | +0.10 | 0.24 |  |
| 140 | 2056 | 451.6 | 448.5 | 140.03 | +0.03 | 0.31 |  |
| 160 | 2278 | 259.8 | 255.3 | 159.44 | -0.56 | 0.45 |  |
| 175 | 2444 | 185.0 | 184.8 | 166.77 | -8.23 | 0.02 | fuera |

## Pasada 3: de 10 en 10°

| Ángulo (°) | Pulso (µs) | mV ↑ | mV ↓ | Medido (°) | Error (°) | Histéresis (°) | |
|---|---|---|---|---|---|---|---|
| 0 | 500 | 1836.6 | 1838.5 | 0.08 | +0.08 | 0.19 |  |
| 10 | 611 | 1743.1 | 1739.2 | 9.80 | -0.20 | 0.39 |  |
| 20 | 722 | 1644.3 | 1639.9 | 19.79 | -0.21 | 0.44 |  |
| 30 | 833 | 1544.4 | 1541.5 | 29.79 | -0.21 | 0.29 |  |
| 40 | 944 | 1448.2 | 1442.1 | 39.66 | -0.34 | 0.62 |  |
| 50 | 1056 | 1345.5 | 1342.9 | 49.84 | -0.16 | 0.26 |  |
| 60 | 1167 | 1243.8 | 1243.3 | 59.99 | -0.01 | 0.05 |  |
| 70 | 1278 | 1144.8 | 1144.6 | 69.96 | -0.04 | 0.02 |  |
| 80 | 1389 | 1043.0 | 1041.3 | 80.31 | +0.31 | 0.17 |  |
| 90 | 1500 | 944.5 | 941.3 | 90.32 | +0.32 | 0.32 |  |
| 100 | 1611 | 843.0 | 839.8 | 100.55 | +0.55 | 0.32 |  |
| 110 | 1722 | 744.3 | 742.2 | 110.45 | +0.45 | 0.21 |  |
| 120 | 1833 | 649.4 | 649.2 | 119.93 | -0.07 | 0.02 |  |
| 130 | 1944 | 553.2 | 548.0 | 129.88 | -0.12 | 0.52 |  |
| 140 | 2056 | 451.8 | 449.9 | 139.95 | -0.05 | 0.19 |  |
| 150 | 2167 | 354.7 | 350.5 | 149.86 | -0.14 | 0.42 |  |
| 160 | 2278 | 256.0 | 257.3 | 159.53 | -0.47 | 0.13 |  |
| 170 | 2389 | 180.6 | 181.0 | 167.18 | -2.82 | 0.04 | fuera |
| 175 | 2444 | 181.2 | 181.2 | 167.14 | -7.86 | 0.00 | fuera |

## Pasada 4: de 5 en 5°

| Ángulo (°) | Pulso (µs) | mV ↑ | mV ↓ | Medido (°) | Error (°) | Histéresis (°) | |
|---|---|---|---|---|---|---|---|
| 0 | 500 | 1837.1 | 1838.9 | 0.03 | +0.03 | 0.18 |  |
| 5 | 556 | 1793.1 | 1790.2 | 4.71 | -0.29 | 0.29 |  |
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
| 72 | 1300 | 1127.4 | 1123.5 | 71.90 | -0.10 | 0.39 |  |
| 74 | 1322 | 1105.1 | 1102.0 | 74.11 | +0.11 | 0.31 |  |
| 76 | 1344 | 1085.9 | 1085.5 | 75.91 | -0.09 | 0.04 |  |
| 78 | 1367 | 1064.0 | 1062.7 | 78.17 | +0.17 | 0.13 |  |
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
| 170 | 2389 | 181.0 | 181.3 | 167.15 | -2.85 | 0.03 | fuera |
| 172 | 2411 | 181.6 | 181.5 | 167.11 | -4.89 | 0.01 | fuera |
| 174 | 2433 | 181.6 | 181.5 | 167.11 | -6.89 | 0.01 | fuera |
| 175 | 2444 | 181.9 | 181.6 | 167.09 | -7.91 | 0.03 | fuera |

## Avisos

- Fuera del rango útil (llegó a su tope o no siguió el comando): 170, 172, 174, 175°.
