flkochu/Arca9/datos/2026-10-29_eficiencia_12_servos/canal2/retroalimentacion.png

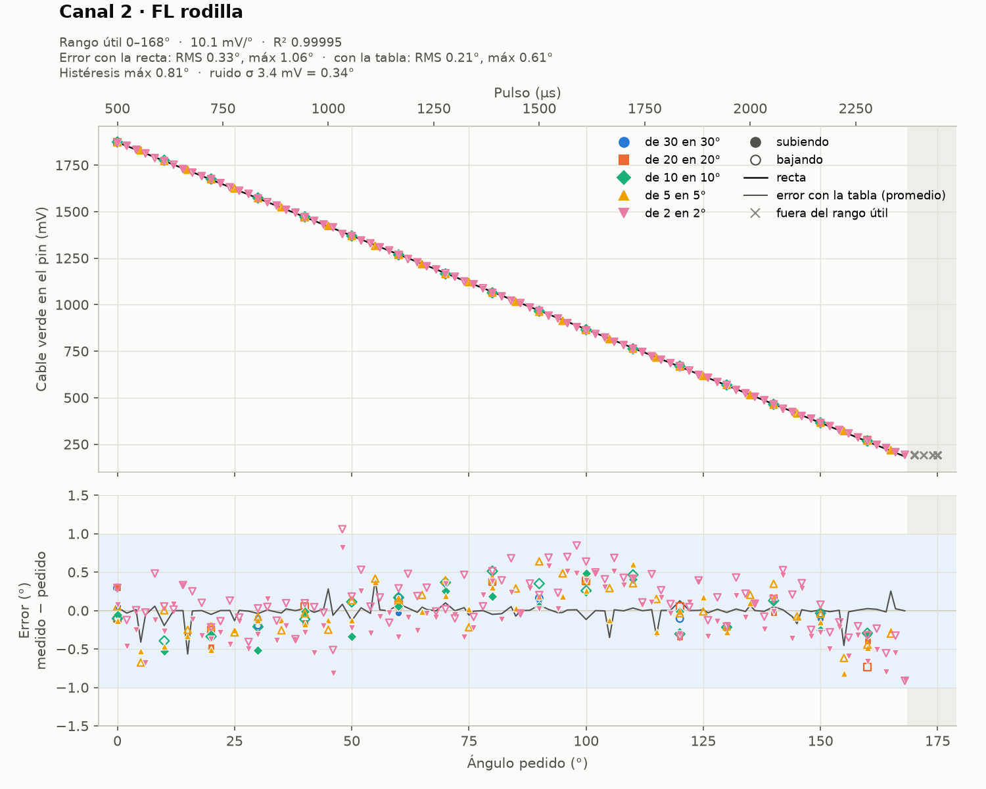
datos/2026-10-29_eficiencia_12_servos/canal2/retroalimentacion.png
