flkochu/Arca9/datos/2026-10-29_eficiencia_12_servos/error_12_servos.png

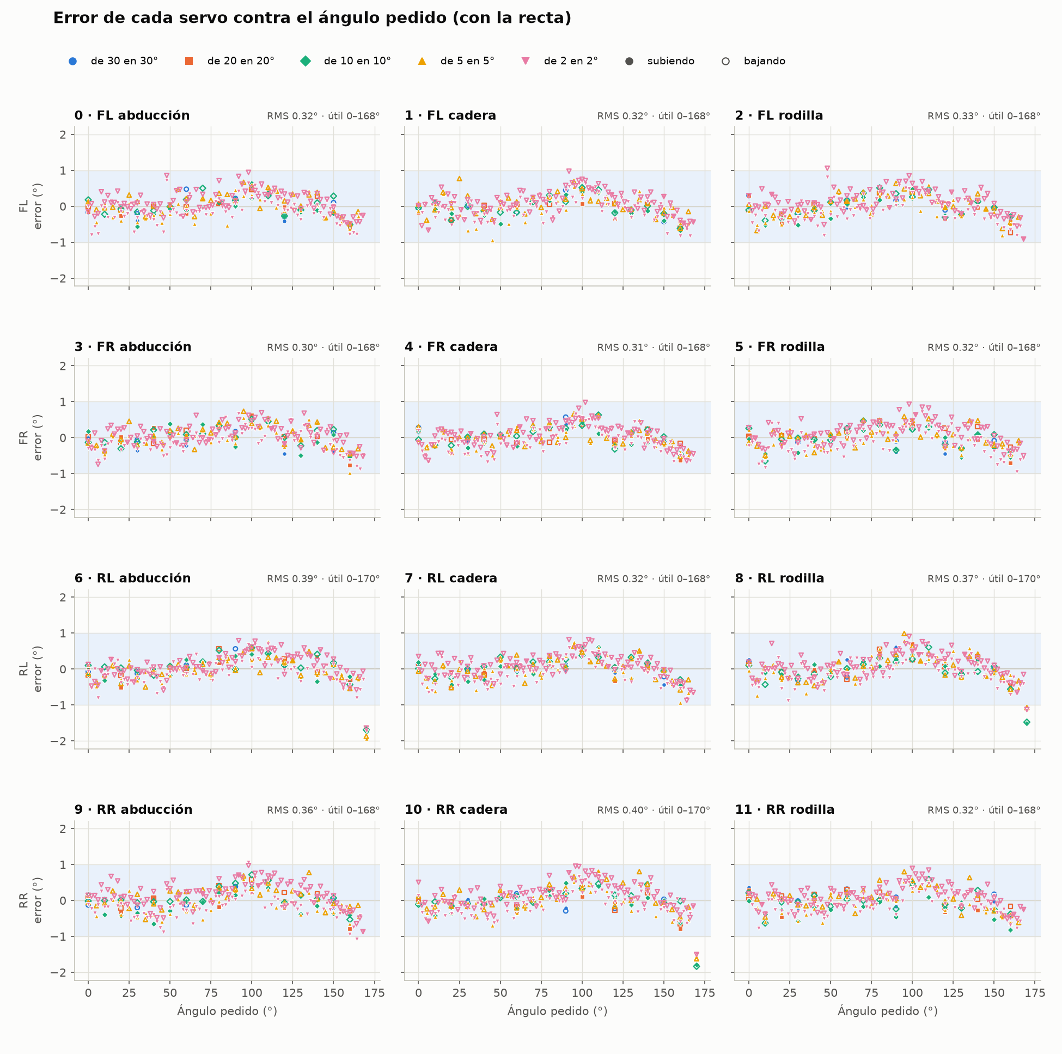
datos/2026-10-29_eficiencia_12_servos/error_12_servos.png
