flkochu/Arca9/datos/2026-11-02_rampas/trazas/canal00.png

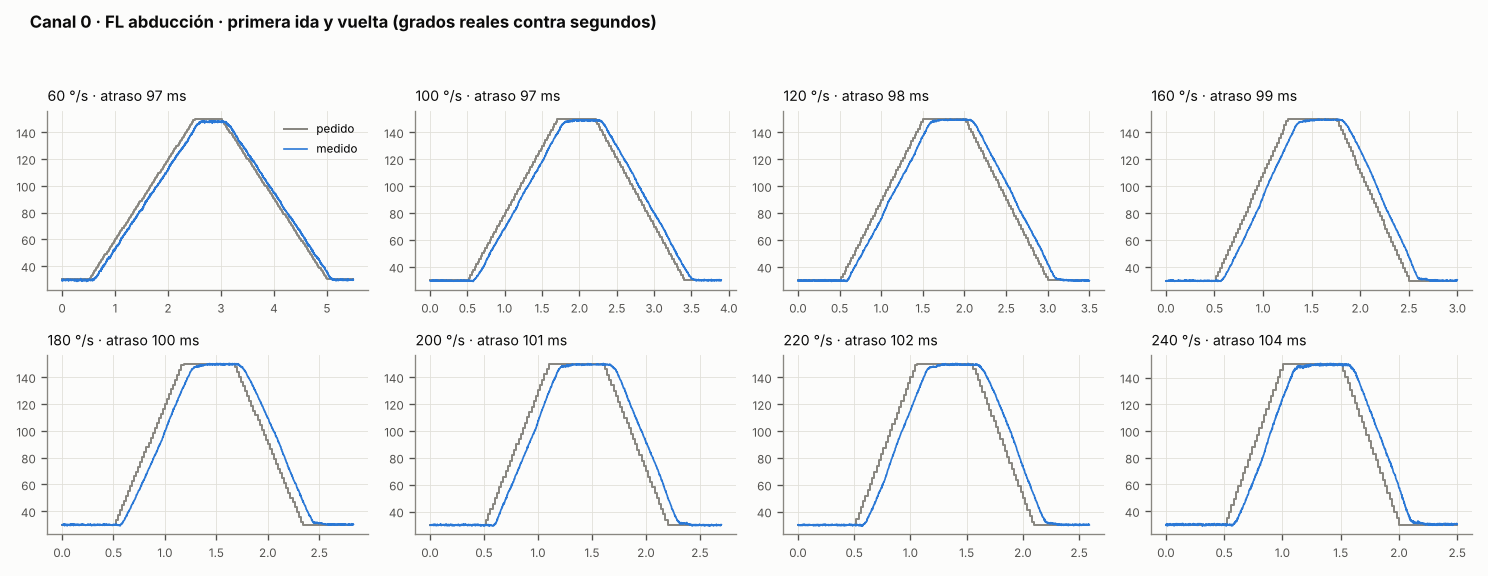
datos/2026-11-02_rampas/trazas/canal00.png
