flkochu/Arca9/datos/2026-11-03_marcha/angulos_2s.png

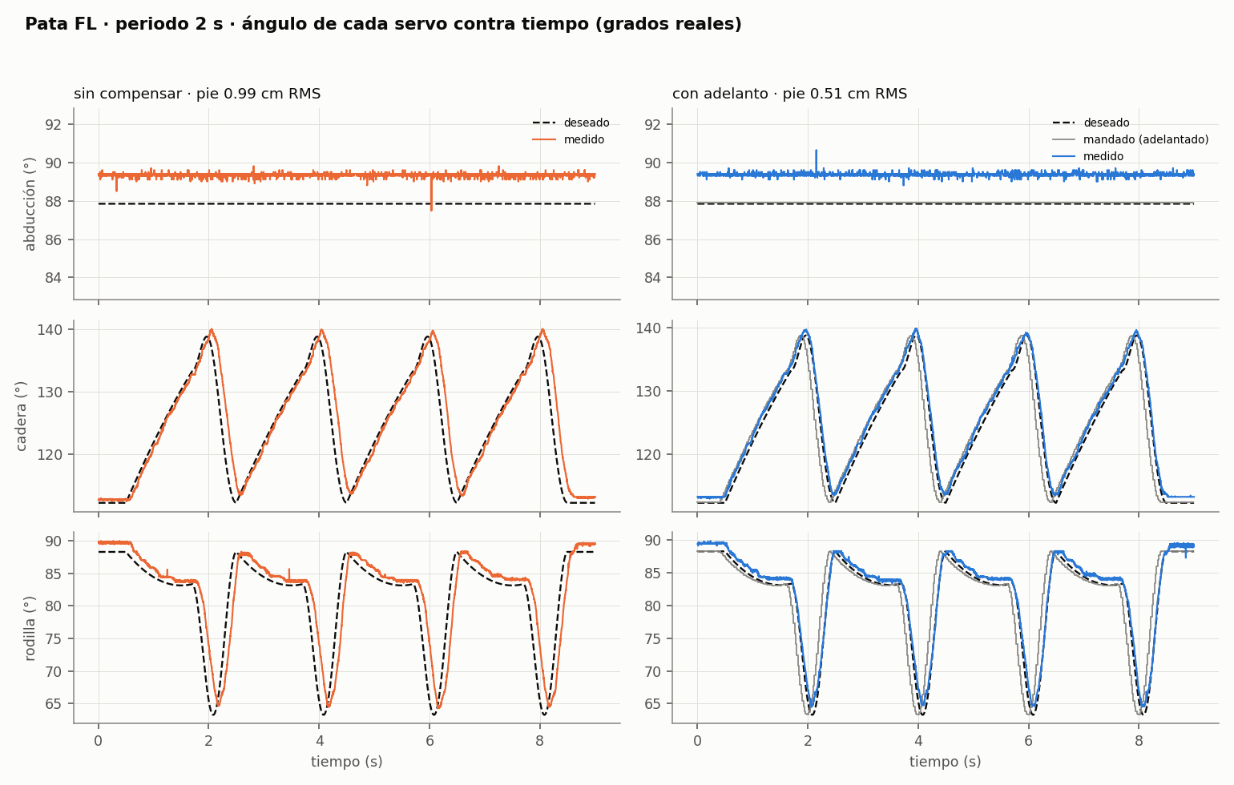
datos/2026-11-03_marcha/angulos_2s.png
