flkochu/Arca9/impresiones/transportador_servo/vista_indicador.png

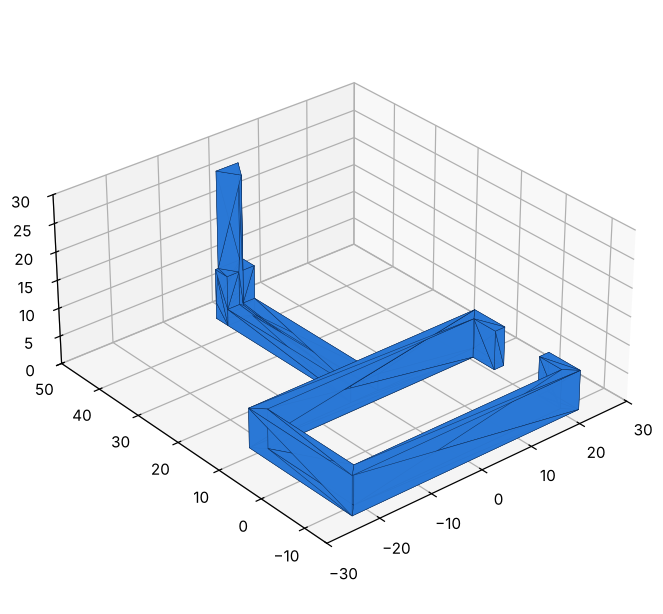
impresiones/transportador_servo/vista_indicador.png
