flkochu/Arca9/impresiones/transportador_servo/placa_transportador.stl

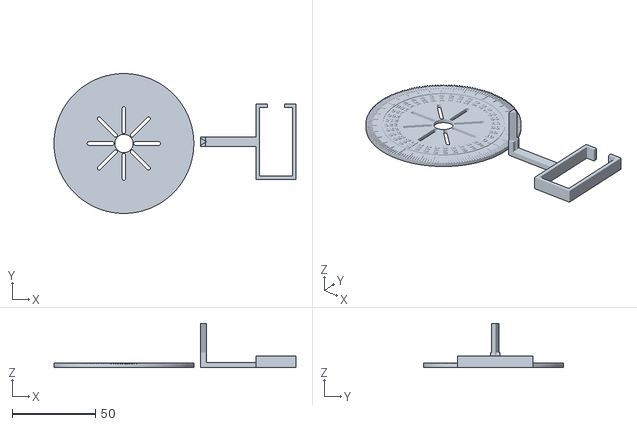
[picture p12: CAD file, 2026-10-30]
impresiones/transportador_servo/placa_transportador.stl
145.4 x 84.0 x 26.5
