flkochu/Arca9/impresiones/transportador_servo/indicador.stl

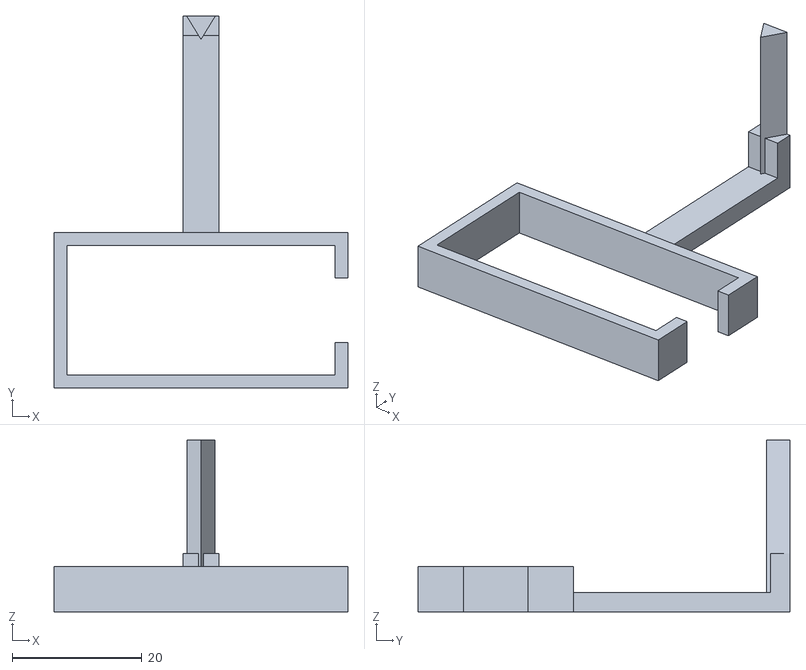
[picture p13: CAD file, 2026-10-30]
impresiones/transportador_servo/indicador.stl
45.4 x 57.4 x 26.5
