flkochu/Arca9/impresiones/transportador_servo/disco_transportador.stl

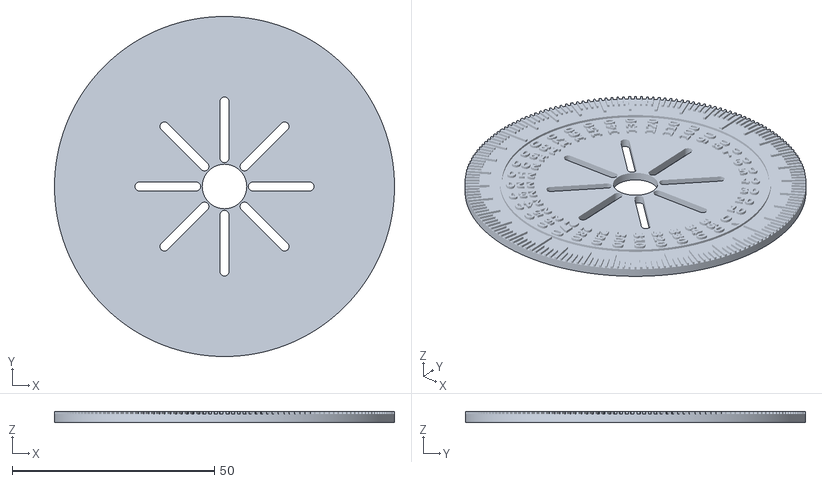
[picture p14: CAD file, 2026-10-30]
impresiones/transportador_servo/disco_transportador.stl
84.0 x 84.0 x 2.60
