flkochu/Arca9/docs/bitacora/README.md

# Bitácora

Una nota por prueba: objetivo, montaje, método, cálculos, resultados y pendientes. Los datos de
cada una están en `datos/`.

| # | Prueba | Fecha |
|---|---|---|
| [01](01_eficiencia_servos.md) | Eficiencia de los 12 servos con retroalimentación | 29 oct 2026 |
| [02](02_angulo_real.md) | Ángulo real del eje, con transportador | 2 nov 2026 |
| [03](03_ruido_auxiliar.md) | Ruido de la ESP32 auxiliar, antes y después de su tierra | pospuesta |
| [04](04_rampas.md) | Rampas: velocidad contra error, los 12 servos | 2 nov 2026 |
| [05](05_marcha_aire.md) | Marcha en el aire con la pata FL | 3 nov 2026 |
| [06](06_puente_agmen.md) | Puente entre Arca9 y Agmen (en simulación) | 5 nov 2026 (Agmen 0.13: 9 nov) |
| [07](07_cuatro_patas.md) | Las 4 patas medidas, con el sentido de cada servo | 9 nov 2026 |
| [08](08_flexion_rapida.md) | Flexión y extensión completas de la rodilla, cada vez más rápido | 9 nov 2026 |
