flkochu/Arca9/pruebas/arnes_firmware/stubs/esp_system.h

#pragma once
// Versión de prueba: en la compu siempre "arranca por encendido".
typedef enum {
  ESP_RST_UNKNOWN, ESP_RST_POWERON, ESP_RST_EXT, ESP_RST_SW, ESP_RST_PANIC, ESP_RST_INT_WDT,
  ESP_RST_TASK_WDT, ESP_RST_WDT, ESP_RST_DEEPSLEEP, ESP_RST_BROWNOUT, ESP_RST_SDIO
} esp_reset_reason_t;
inline esp_reset_reason_t esp_reset_reason() { return ESP_RST_POWERON; }
