flkochu/Arca9/(commit log)

2026-10-30 Add files via upload
    Arca9 desde cero: prueba de eficiencia de los 12 servos
    [calibracion_servos.json, disco_transportador.stl, indicador.stl, mediciones.csv, placa_transportador.stl, plan.csv, resumen.csv, tabla.csv]
2026-11-03 Add files via upload
    Pruebas 02, 03 y 04
    [ciclos.csv, comandos.csv, giro_real.csv, metricas.csv, muestras.csv, resumen.csv]
2026-11-03 Add files via upload
    Scripts de las pruebas 03 y 04
2026-11-03 Add files via upload
    Archivos que faltaban de las pruebas 03 y 04
2026-11-04 Add files via upload
    Pruebas 05: protocolo v3, pata FL y marcha
    [comandos.csv, corridas.csv, metricas.csv, muestras.csv]
2026-11-05 Puente entre Arca9 y Agmen: ver y manejar el perro desde el panel
    pc/agmen/ (nota 06 de la bitácora):
    - arca9.agmen: Arca9Articulaciones{f32[12] q}, Arca9Comando (12 ángulos
    objetivo + activo) y Arca9Estado (conectado, PROTO, RESET, errores...).
    - puente.py: nodo de Agmen que usa la clase ESP32 de arca9_serial.py y,
    a 50 Hz con el comando S, manda los pulsos y publica las 12 lecturas en
    grados reales (escala.py). Límites de pata.py, velocidad limitada (60 °/s
    por defecto, tope 120), arranque sin saltos y uno por ciclo, watchdog de
    0.5 s, detecta y publica los reinicios de la ESP32 (mensaje REINICIO) y
    manda D al cerrar. Los servos sin pata medida no se mueven.
    - poses.py: par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
    [esp32_falsa.py, perro.py, poses.py, prueba_puente.py, puente.py]
2026-11-10 Add files via upload
    Inclusion de Agmen y pruebas adicionales
    [comandos.csv, corridas.csv, metricas.csv, muestras.csv]
